S0urceror/HexAgon/3d/stm32f103vet6.stp

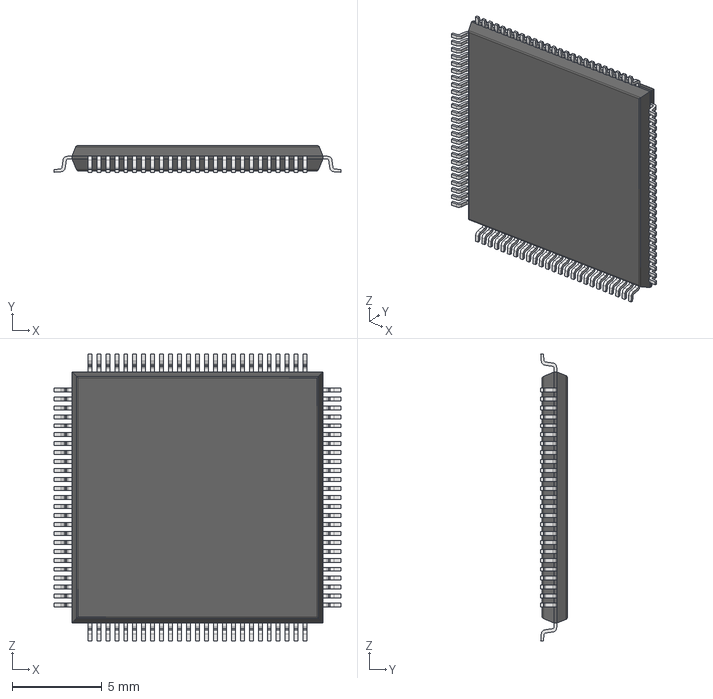
[picture p1: CAD file, 2025-05-18]
3d/stm32f103vet6.stp
16.0 x 1.48 x 16.0 mm
