S0urceror/HexAgon/3d/ESP32-PICO-D4.STEP

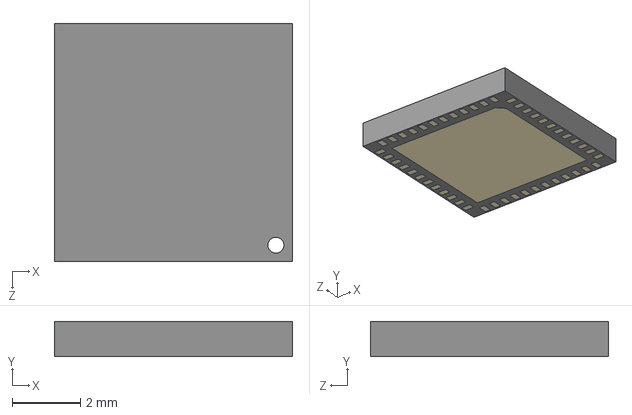
[picture p2: CAD file, 2025-05-18]
3d/ESP32-PICO-D4.STEP
7.00 x 1.04 x 7.00 mm
