S0urceror/HexAgon/3d/HN1x2-PinHeader_1x02_P2.54mm_Vertical.step

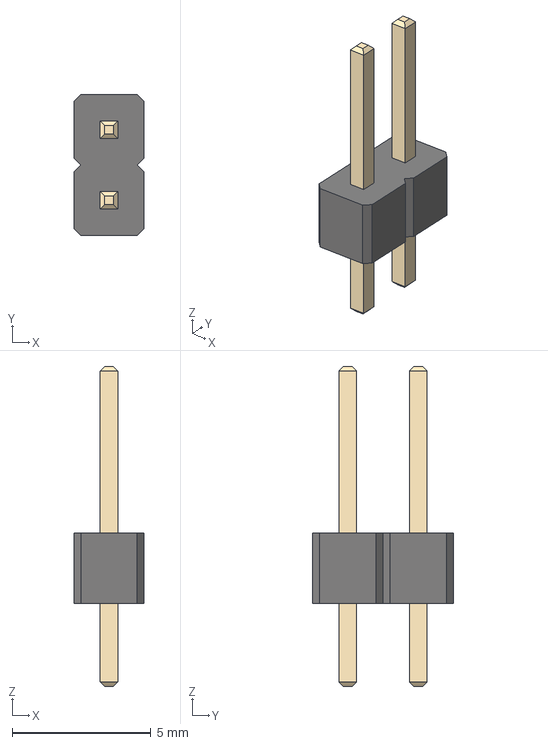
[picture p3: CAD file, 2025-05-18]
3d/HN1x2-PinHeader_1x02_P2.54mm_Vertical.step
2.54 x 5.08 x 11.5 mm
