S0urceror/HexAgon/3d/Audio_Jack-3.5mm---CUI_SJ1-3515-SMT-TR.step

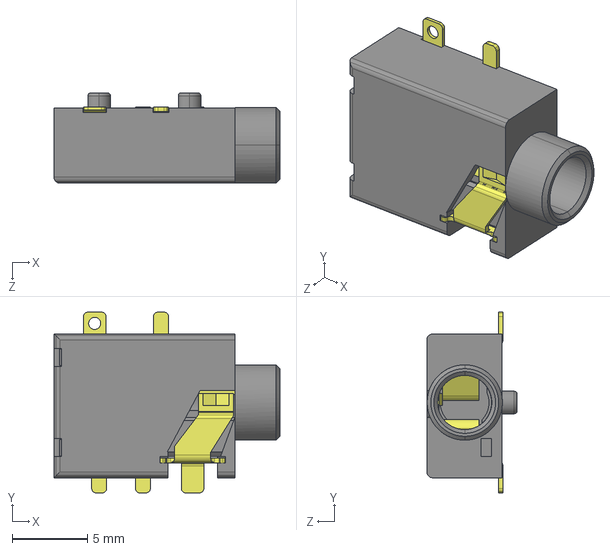
[picture p4: CAD file, 2025-05-18]
3d/Audio_Jack-3.5mm---CUI_SJ1-3515-SMT-TR.step
15.0 x 12.0 x 6.00 mm
