S0urceror/HexAgon/3d/TFC-WPAPR-08---112J-TXAR-R_C_1-1.STEP

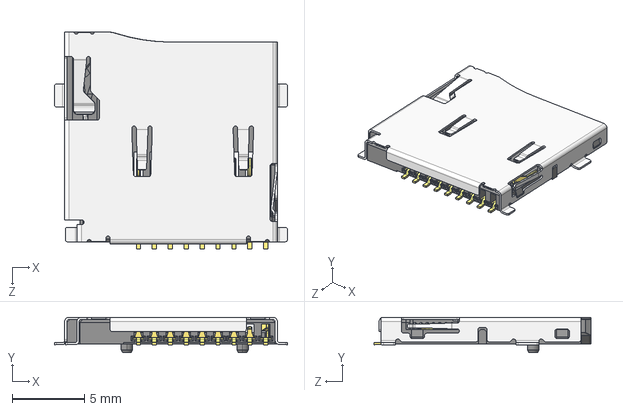
[picture p5: CAD file, 2025-05-18]
3d/TFC-WPAPR-08---112J-TXAR-R_C_1-1.STEP
16.1 x 2.45 x 15.0 mm
