S0urceror/HexAgon/3d/BH-10__64.step

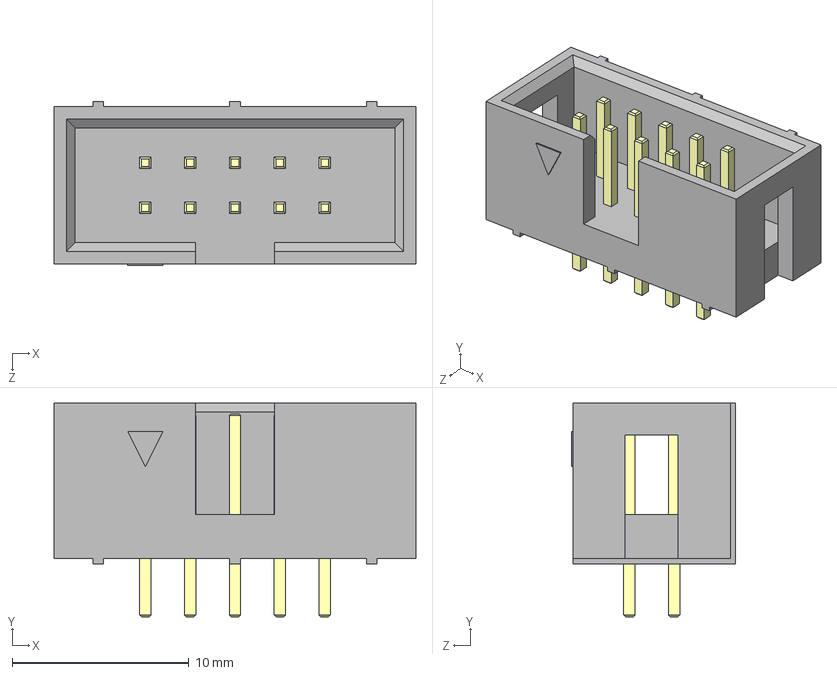
[picture p6: CAD file, 2025-05-18]
3d/BH-10__64.step
20.5 x 12.1 x 9.30 mm
