S0urceror/HexAgon/3d/SOT-23-6.step

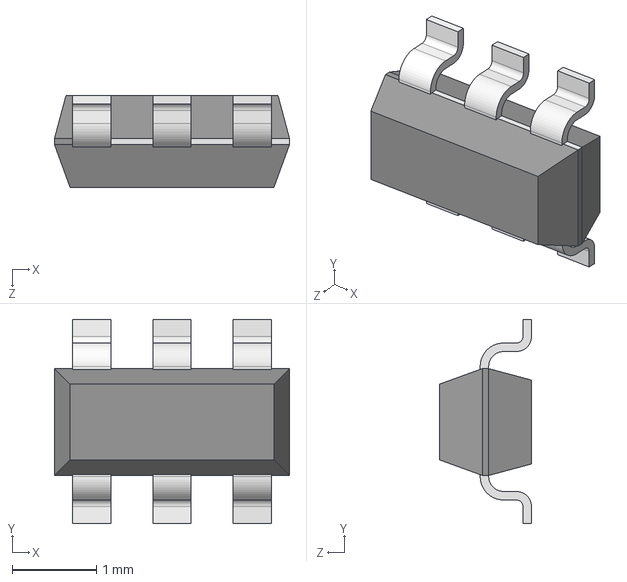
[picture p7: CAD file, 2025-05-18]
3d/SOT-23-6.step
2.79 x 2.43 x 1.09 mm
