S0urceror/HexAgon/3d/Header_right_angle_10way(2x5).step

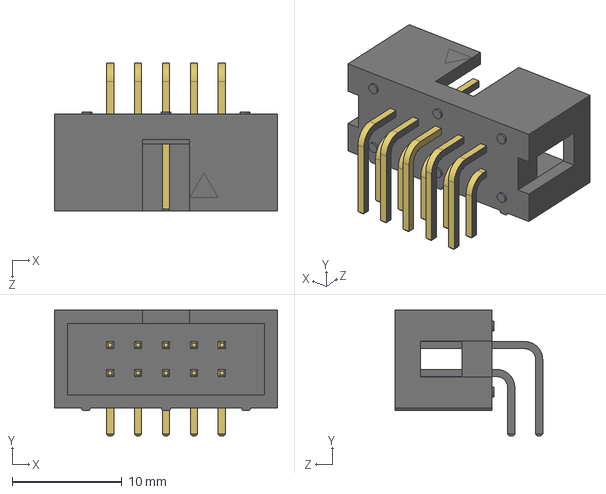
[picture p8: CAD file, 2025-05-18]
3d/Header_right_angle_10way(2x5).step
20.3 x 11.4 x 13.4 mm
