S0urceror/HexAgon/3d/User Library-SLIM D-SUB RIGHT ANGLE PCB MOUNT.step

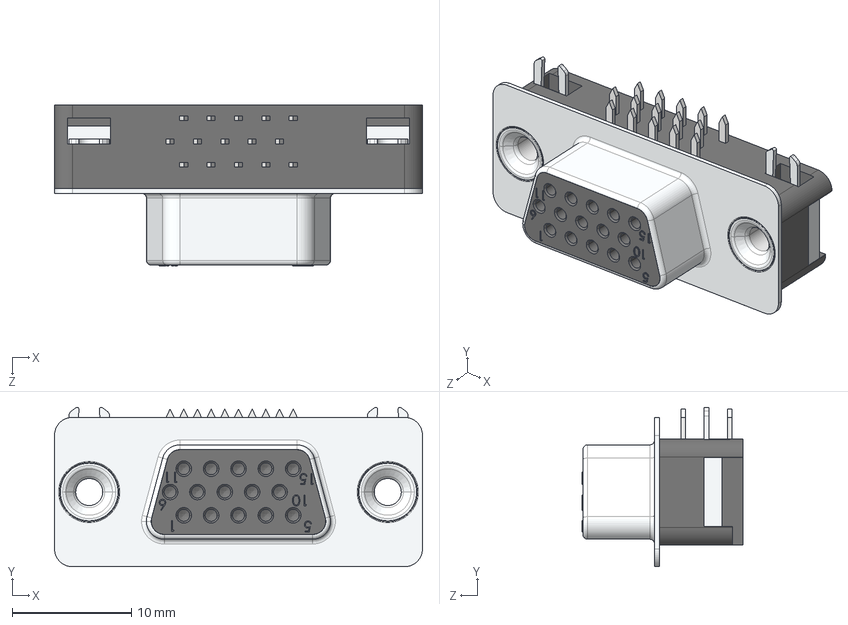
[picture p9: CAD file, 2025-05-18]
3d/User Library-SLIM D-SUB RIGHT ANGLE PCB MOUNT.step
30.8 x 13.3 x 13.5 mm
