S0urceror/HexAgon/3d/ALSRobot-BUZZER.step

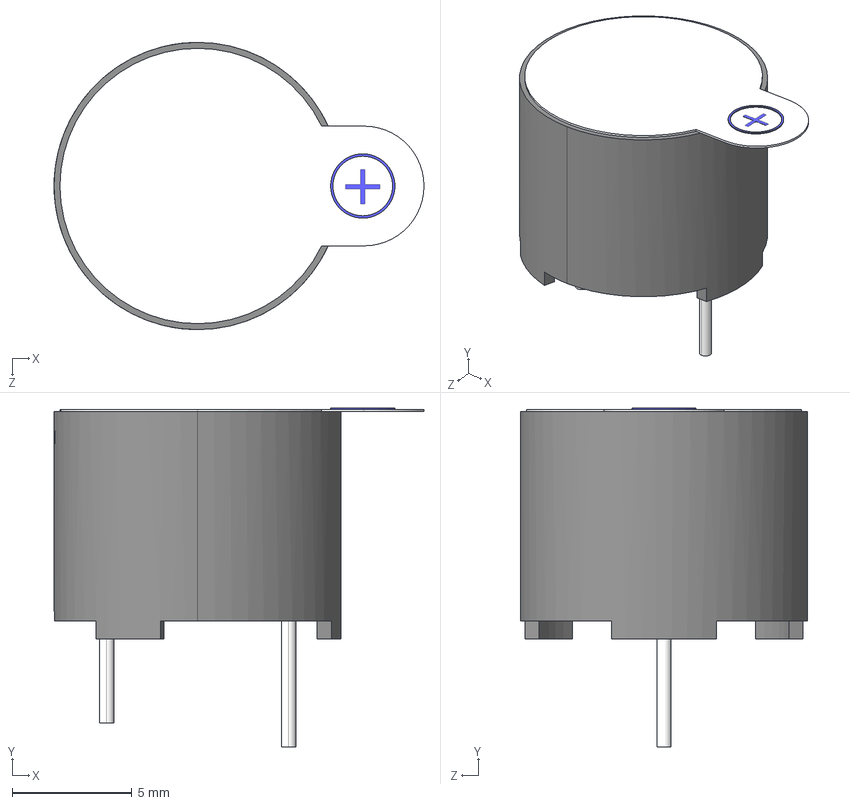
[picture p10: CAD file, 2025-05-18]
3d/ALSRobot-BUZZER.step
15.5 x 14.2 x 12.0 mm
