S0urceror/HexAgon/3d/HN1x4-PinHeader_1x04_P2.54mm_Vertical.step

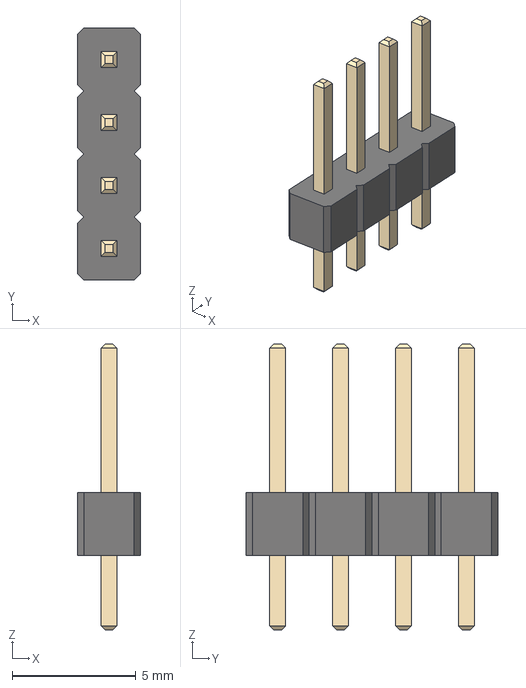
[picture p11: CAD file, 2025-05-18]
3d/HN1x4-PinHeader_1x04_P2.54mm_Vertical.step
2.54 x 10.2 x 11.5 mm
