S0urceror/HexAgon/3d/L-CD32_shielded.step

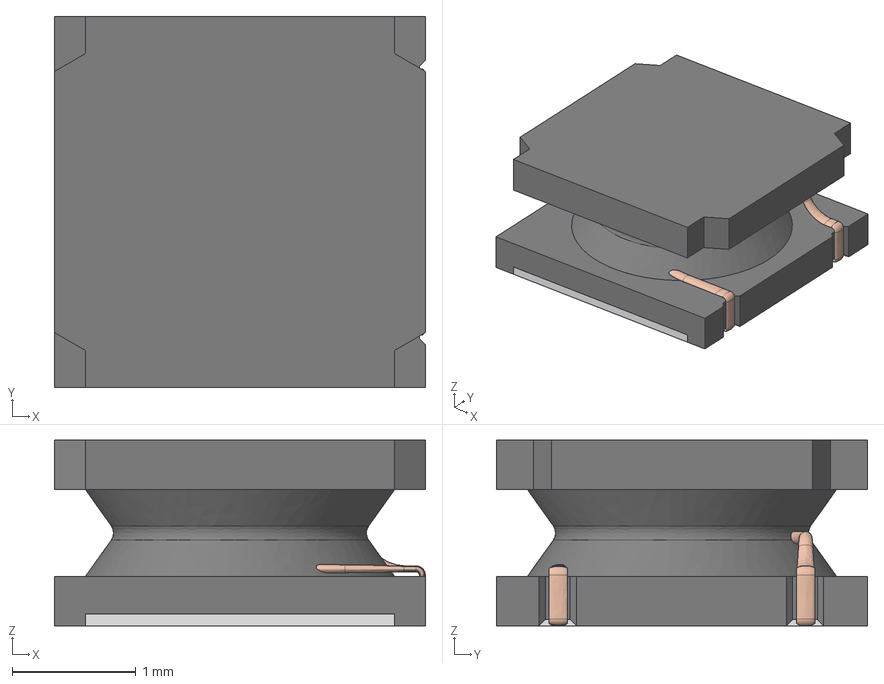
[picture p12: CAD file, 2025-05-18]
3d/L-CD32_shielded.step
3.00 x 3.00 x 1.50 mm
