S0urceror/HexAgon/3d/User Library-SOT50P160X60-6.step

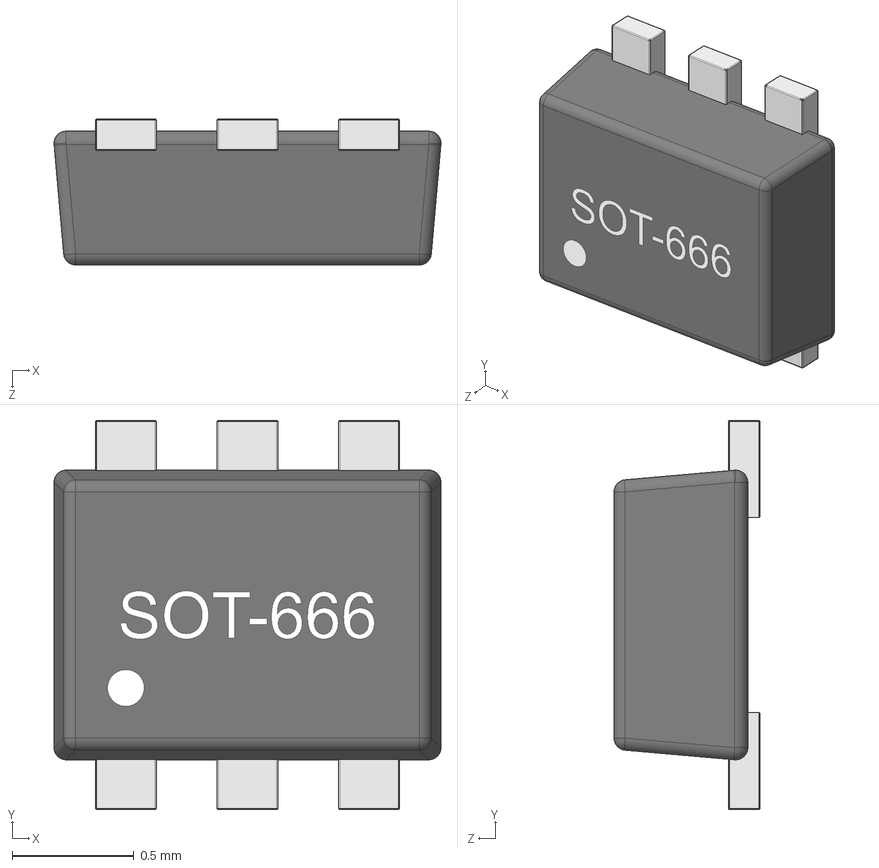
[picture p13: CAD file, 2025-05-18]
3d/User Library-SOT50P160X60-6.step
1.59 x 1.60 x 0.6 mm
