S0urceror/HexAgon/3d/User_Library-TSOP2-44.STEP

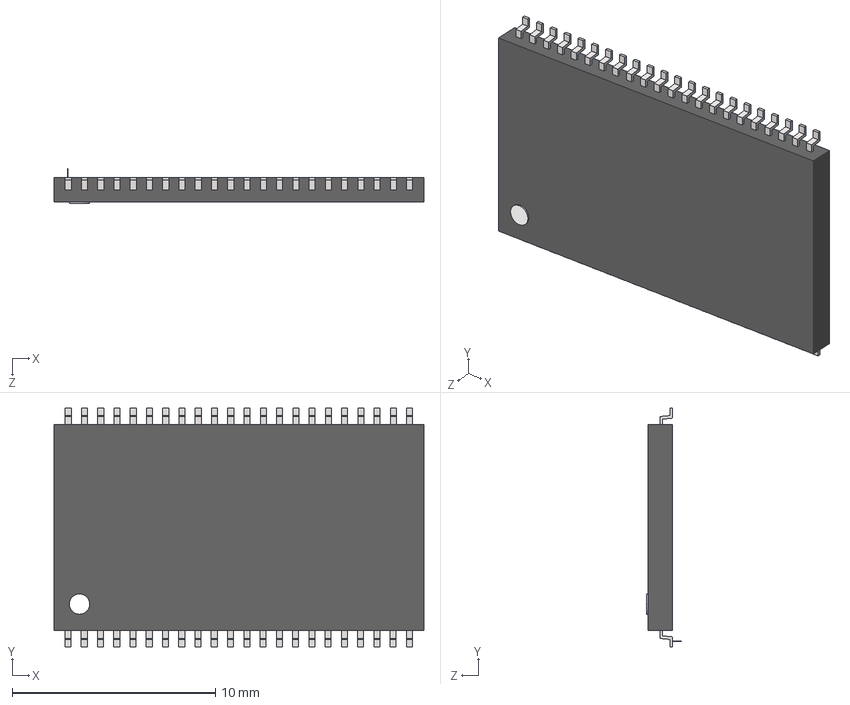
[picture p14: CAD file, 2025-05-18]
3d/User_Library-TSOP2-44.STEP
18.2 x 11.8 x 1.70 mm
Extruded2 x 44
Board4 x 44
Extruded3
Board3
Board5
