S0urceror/HexAgon/3d/SOD123.step

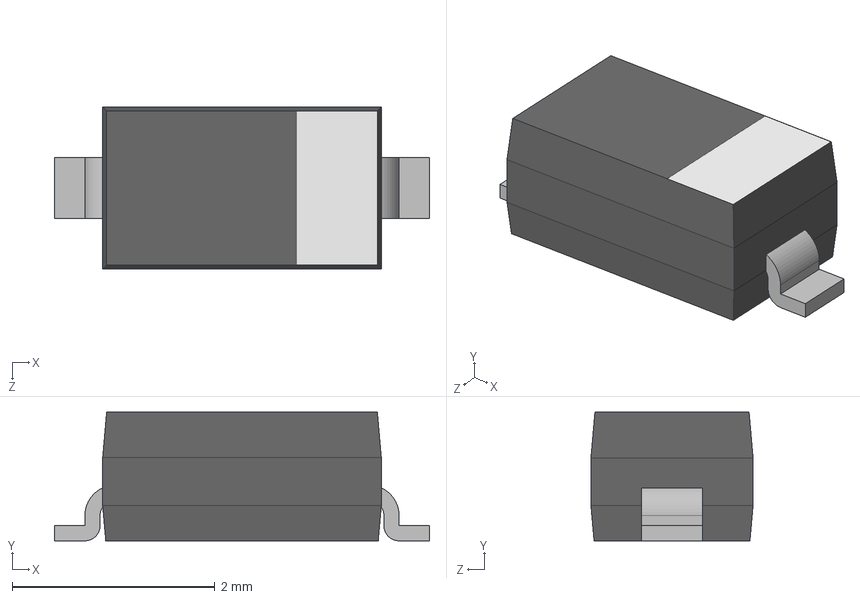
[picture p15: CAD file, 2025-05-18]
3d/SOD123.step
3.70 x 1.27 x 1.60 mm
