S0urceror/HexAgon/3d/SOT-23-5.step

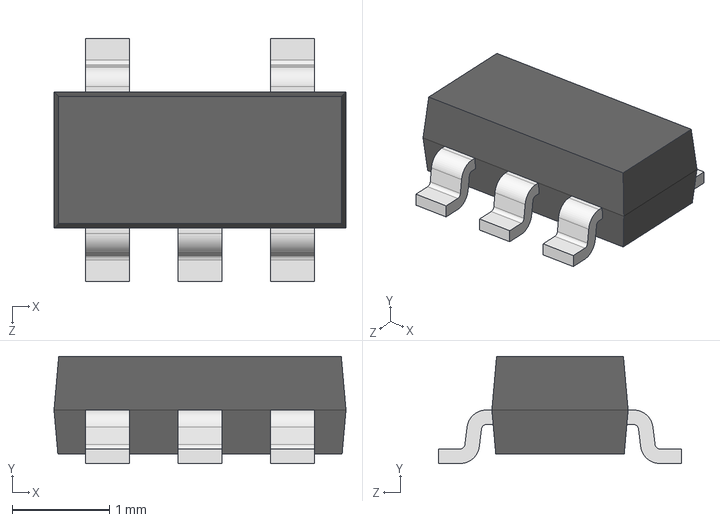
[picture p16: CAD file, 2025-05-18]
3d/SOT-23-5.step
3.00 x 1.10 x 2.50 mm
