S0urceror/HexAgon/3d/QSG5032.step

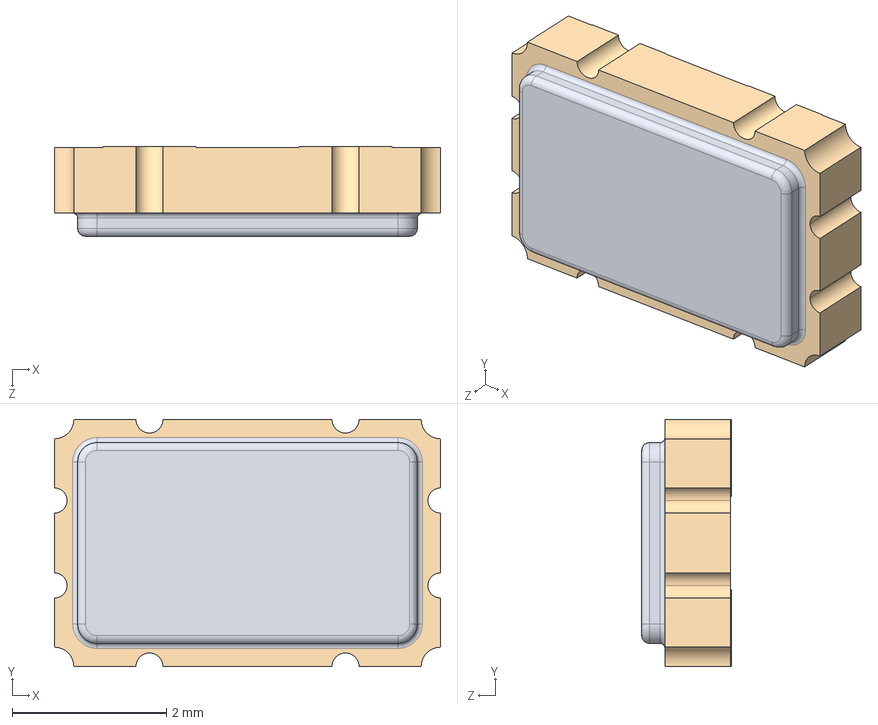
[picture p18: CAD file, 2025-05-18]
3d/QSG5032.step
5.00 x 3.20 x 1.16 mm
