S0urceror/HexAgon/3d/SO-8_150mil---SN65HVDA1050AQDRQ1.STEP

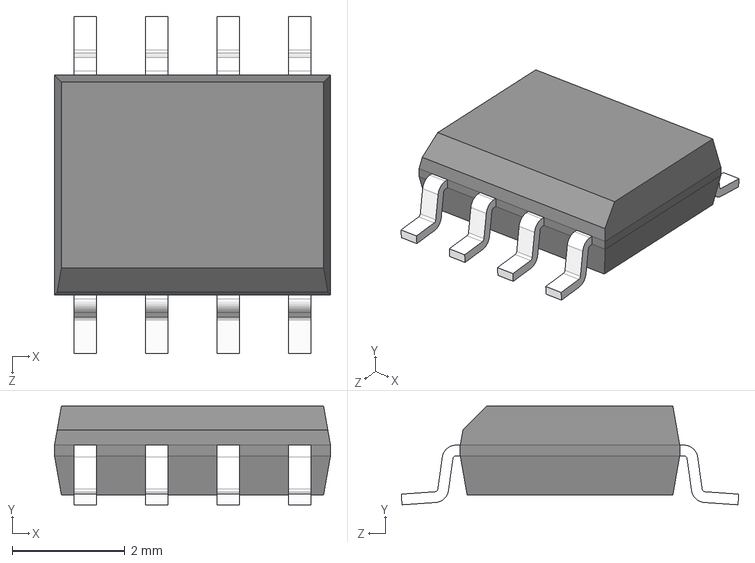
[picture p19: CAD file, 2025-05-18]
3d/SO-8_150mil---SN65HVDA1050AQDRQ1.STEP
4.90 x 1.75 x 5.99 mm
