S0urceror/HexAgon/3d/72w2538_292303-4.stp

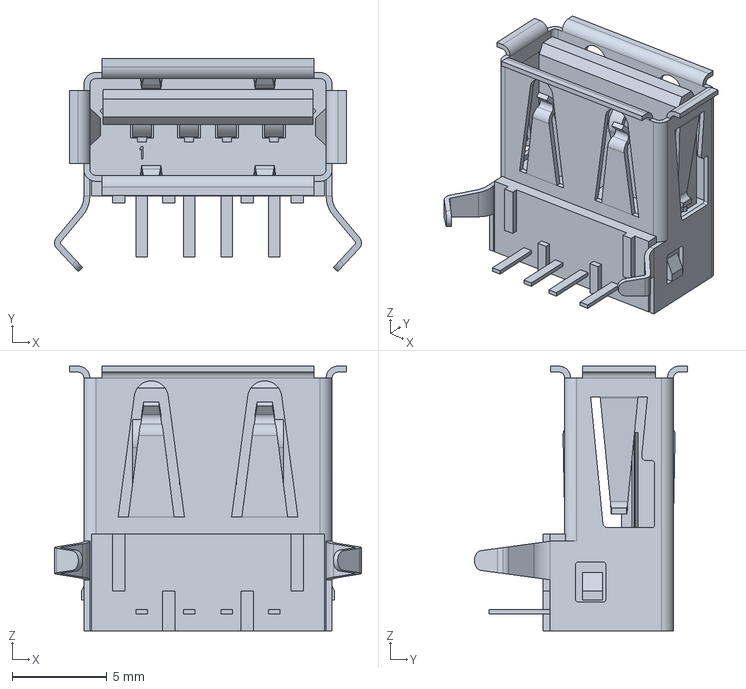
[picture p20: CAD file, 2025-05-18]
3d/72w2538_292303-4.stp
16.2 x 11.3 x 14.0 mm
