S0urceror/HexAgon/3d/JST_B2B-PH-SM4-TB(DW02R).step

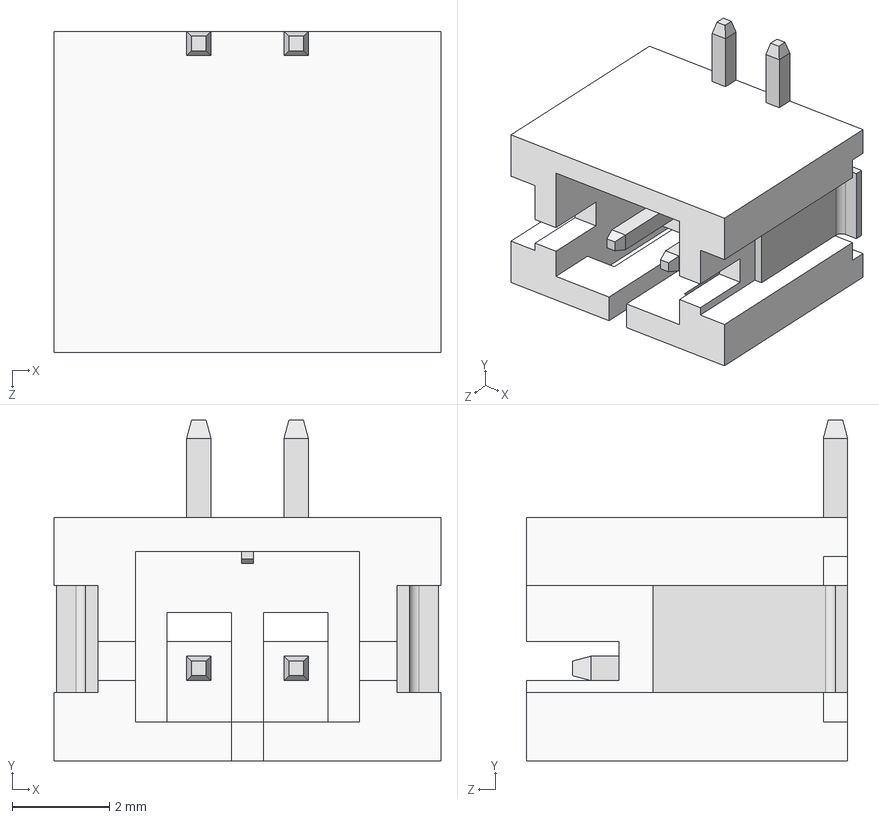
[picture p21: CAD file, 2025-05-18]
3d/JST_B2B-PH-SM4-TB(DW02R).step
7.95 x 7.00 x 6.60 mm
