S0urceror/HexAgon/3d/BH34R_CH87342H100.STEP

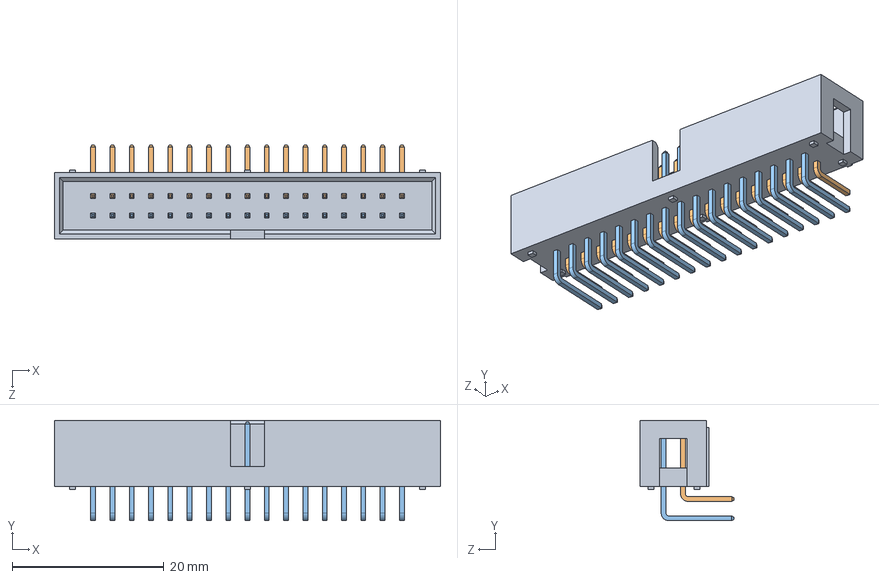
[picture p22: CAD file, 2025-05-18]
3d/BH34R_CH87342H100.STEP
50.8 x 13.2 x 12.4 mm
CH87 BASE_34
H TYPEµuPIN x 17
H TYPEªøPIN x 17
