S0urceror/HexAgon/3d/DO-214AC_SMA.step

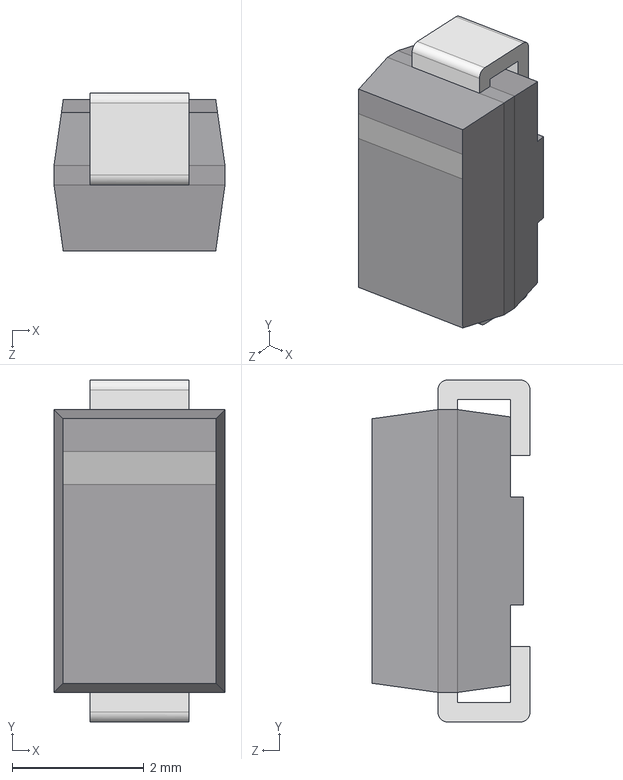
[picture p23: CAD file, 2025-05-18]
3d/DO-214AC_SMA.step
2.60 x 5.20 x 2.40 mm
