S0urceror/HexAgon/3d/B3F_3150.step

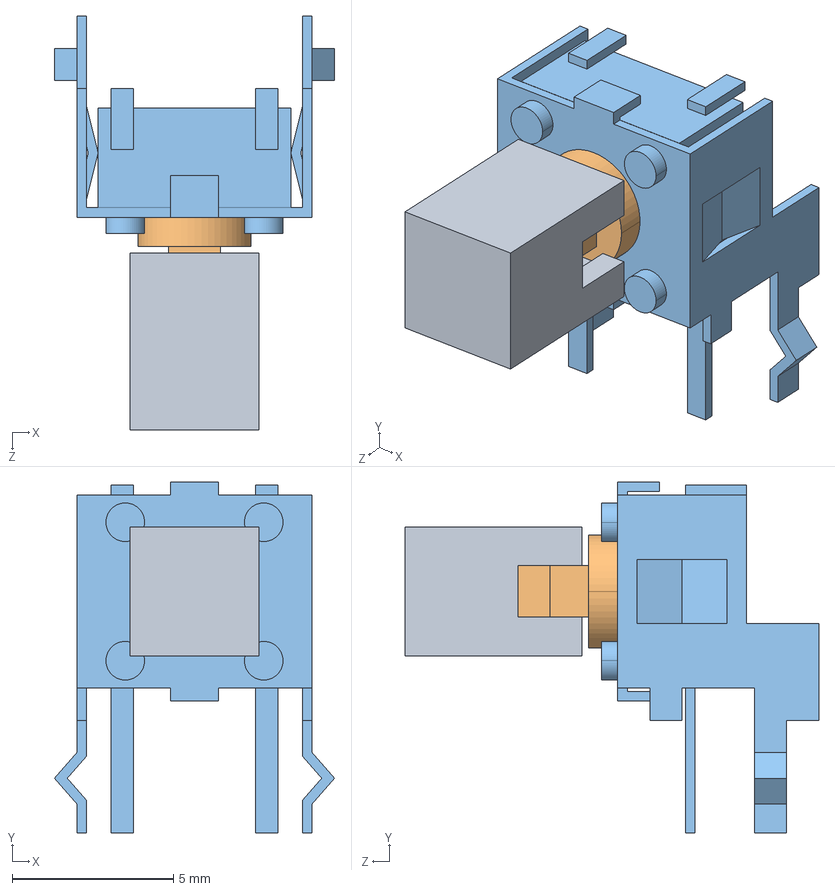
[picture p24: CAD file, 2025-05-18]
3d/B3F_3150.step
8.70 x 10.9 x 12.9 mm
B32_1000
B3F_3150_BUTTON
B3F_3150_BASE
