S0urceror/HexAgon/3d/ESP32-S3-WROOM-1-N8R8.STEP

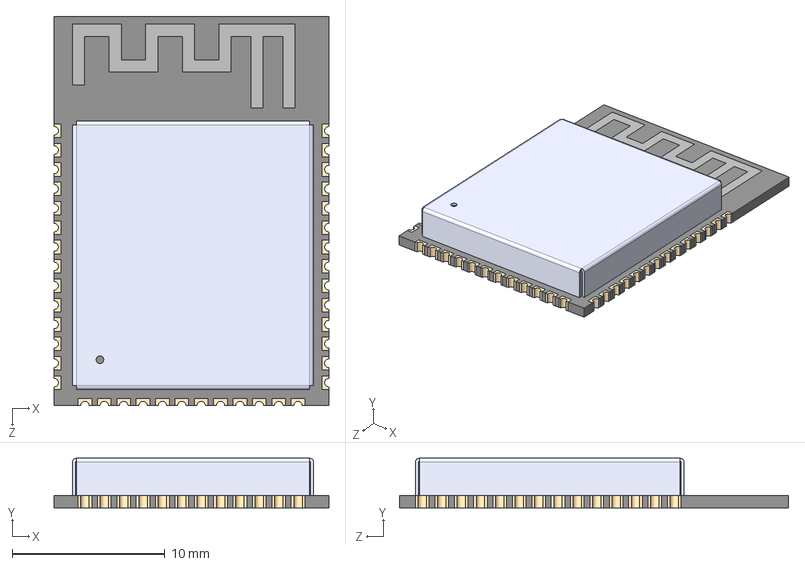
[picture p25: CAD file, 2025-05-18]
3d/ESP32-S3-WROOM-1-N8R8.STEP
18.0 x 3.25 x 25.5 mm
