S0urceror/HexAgon/16bitLCDSS1963/7inch_SSD1963_display_‘≠¿ÌÕº.pdf

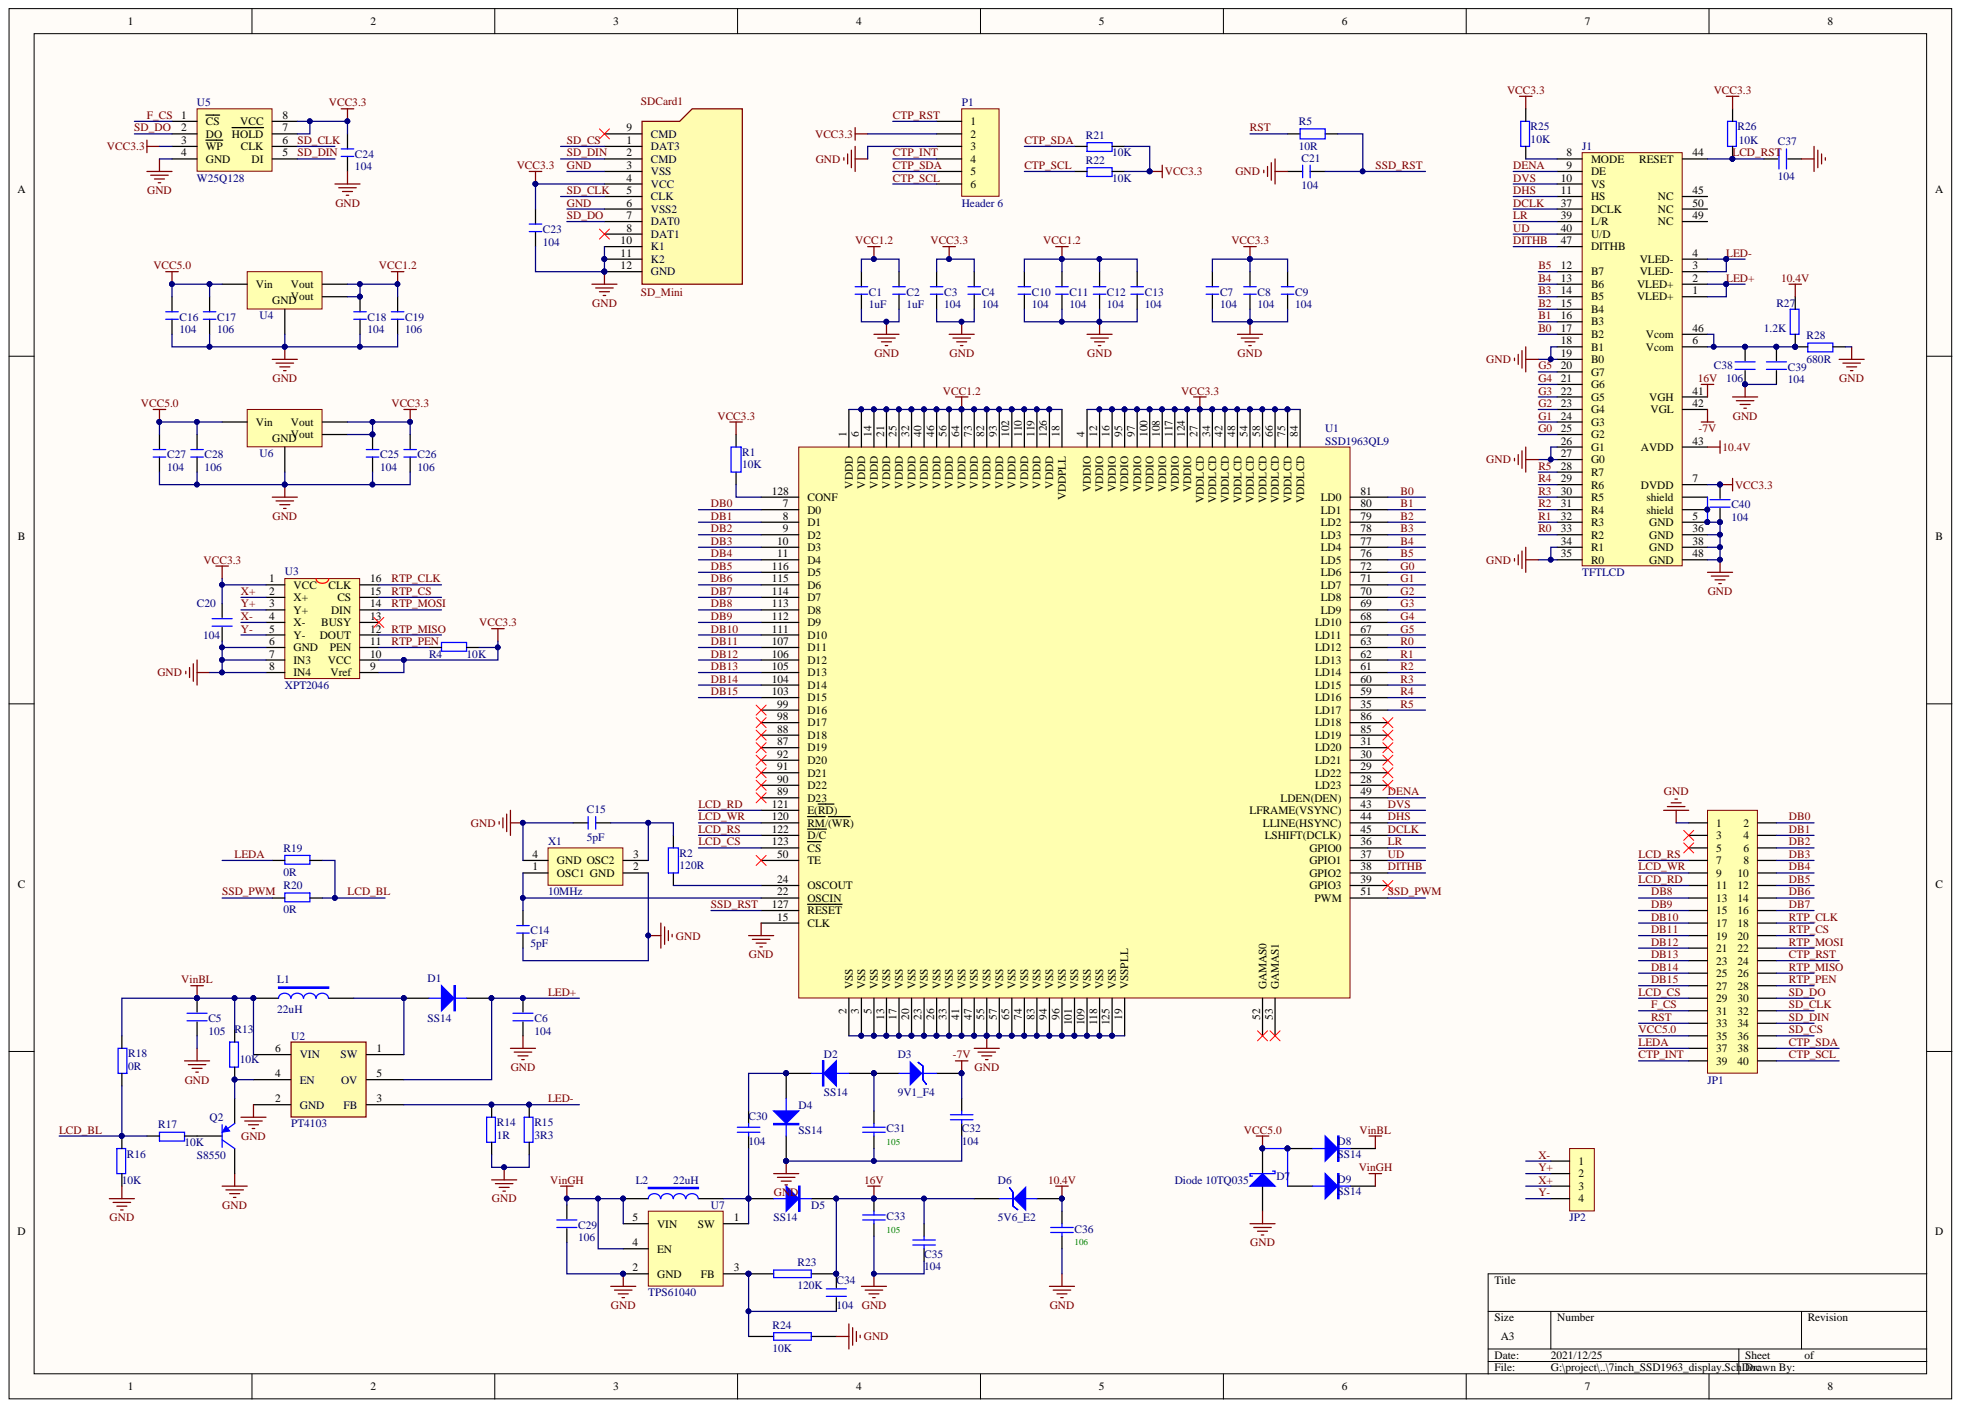
[picture p26: page 1]

GND 2 | LED-
