S0urceror/HexAgon/16bitLCDSS1963/7inch_SSD1963_display_≥ﬂ¥ÁÕº.pdf

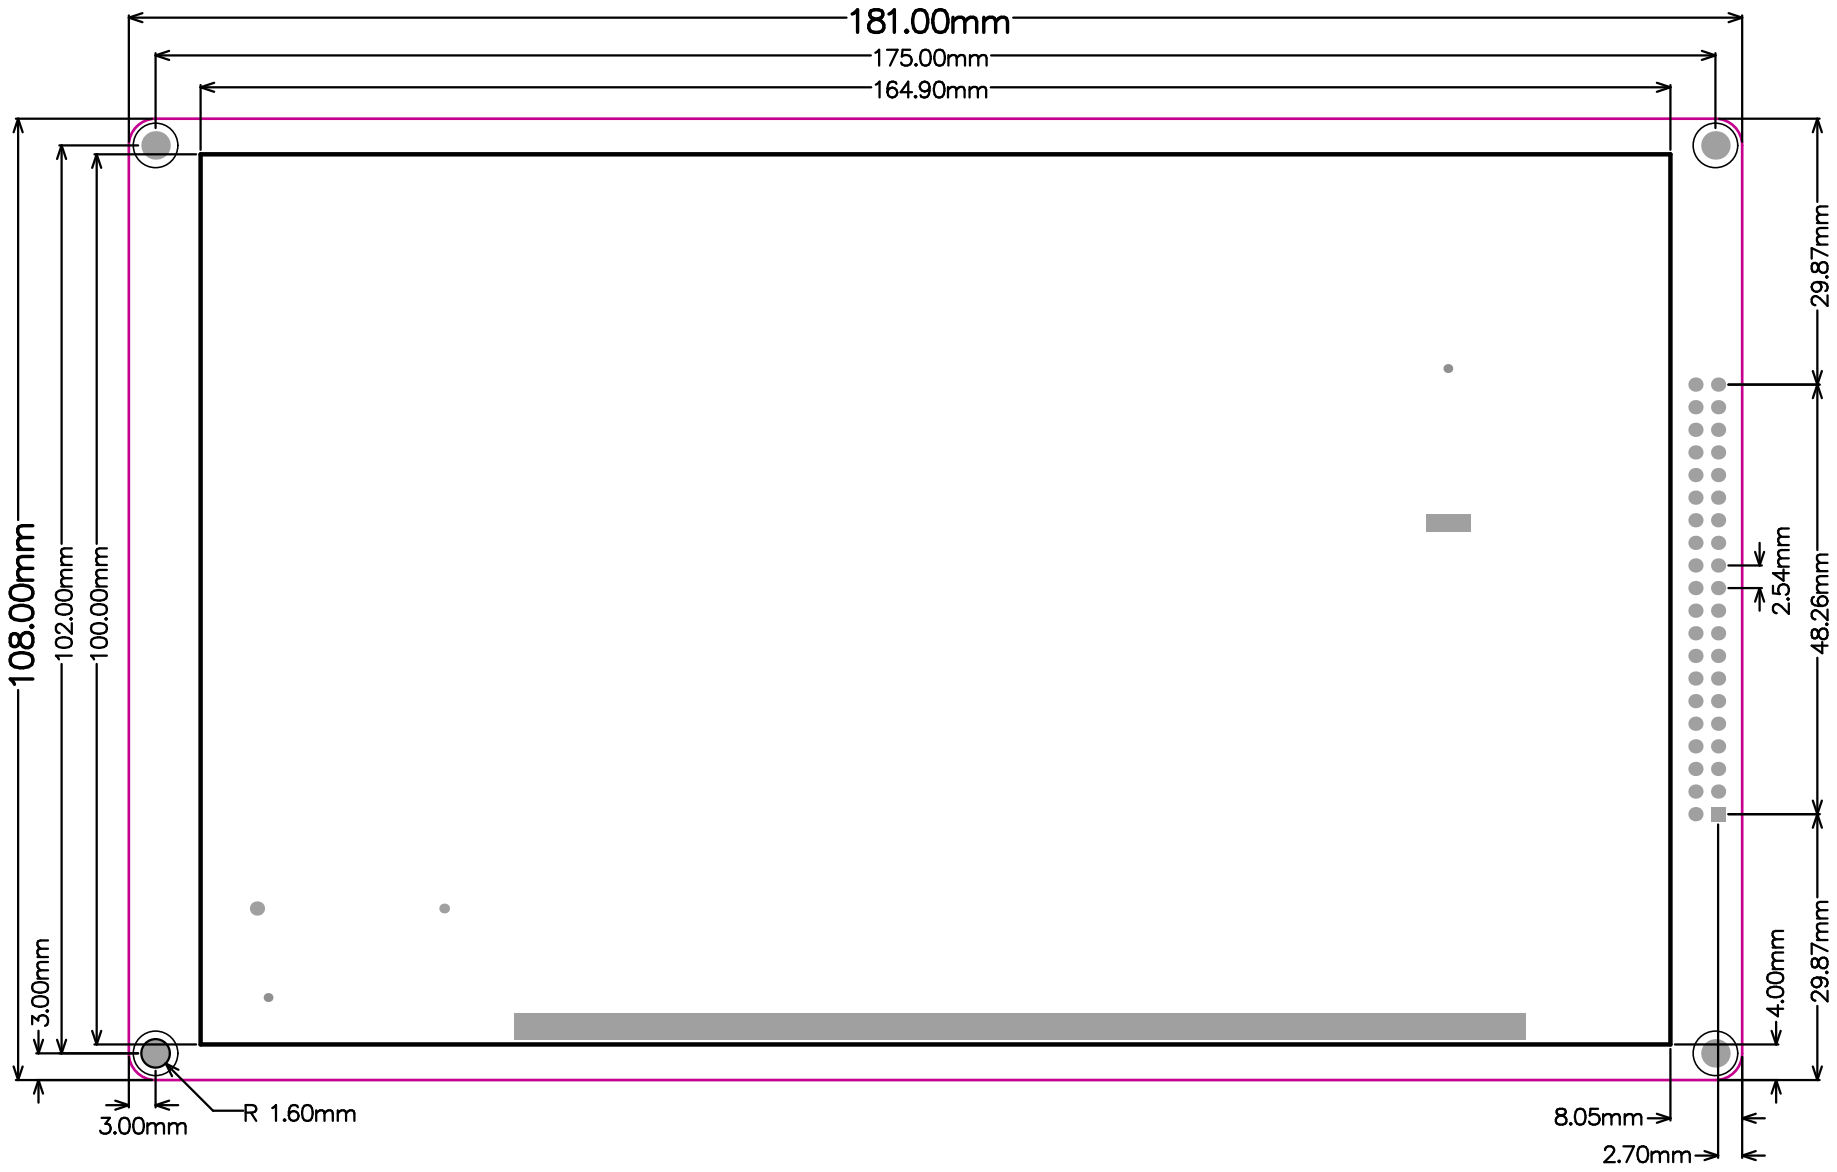
[picture p27: page 1]
