S0urceror/HexAgon/16bitLCDSS1963/TPM7216C.pdf

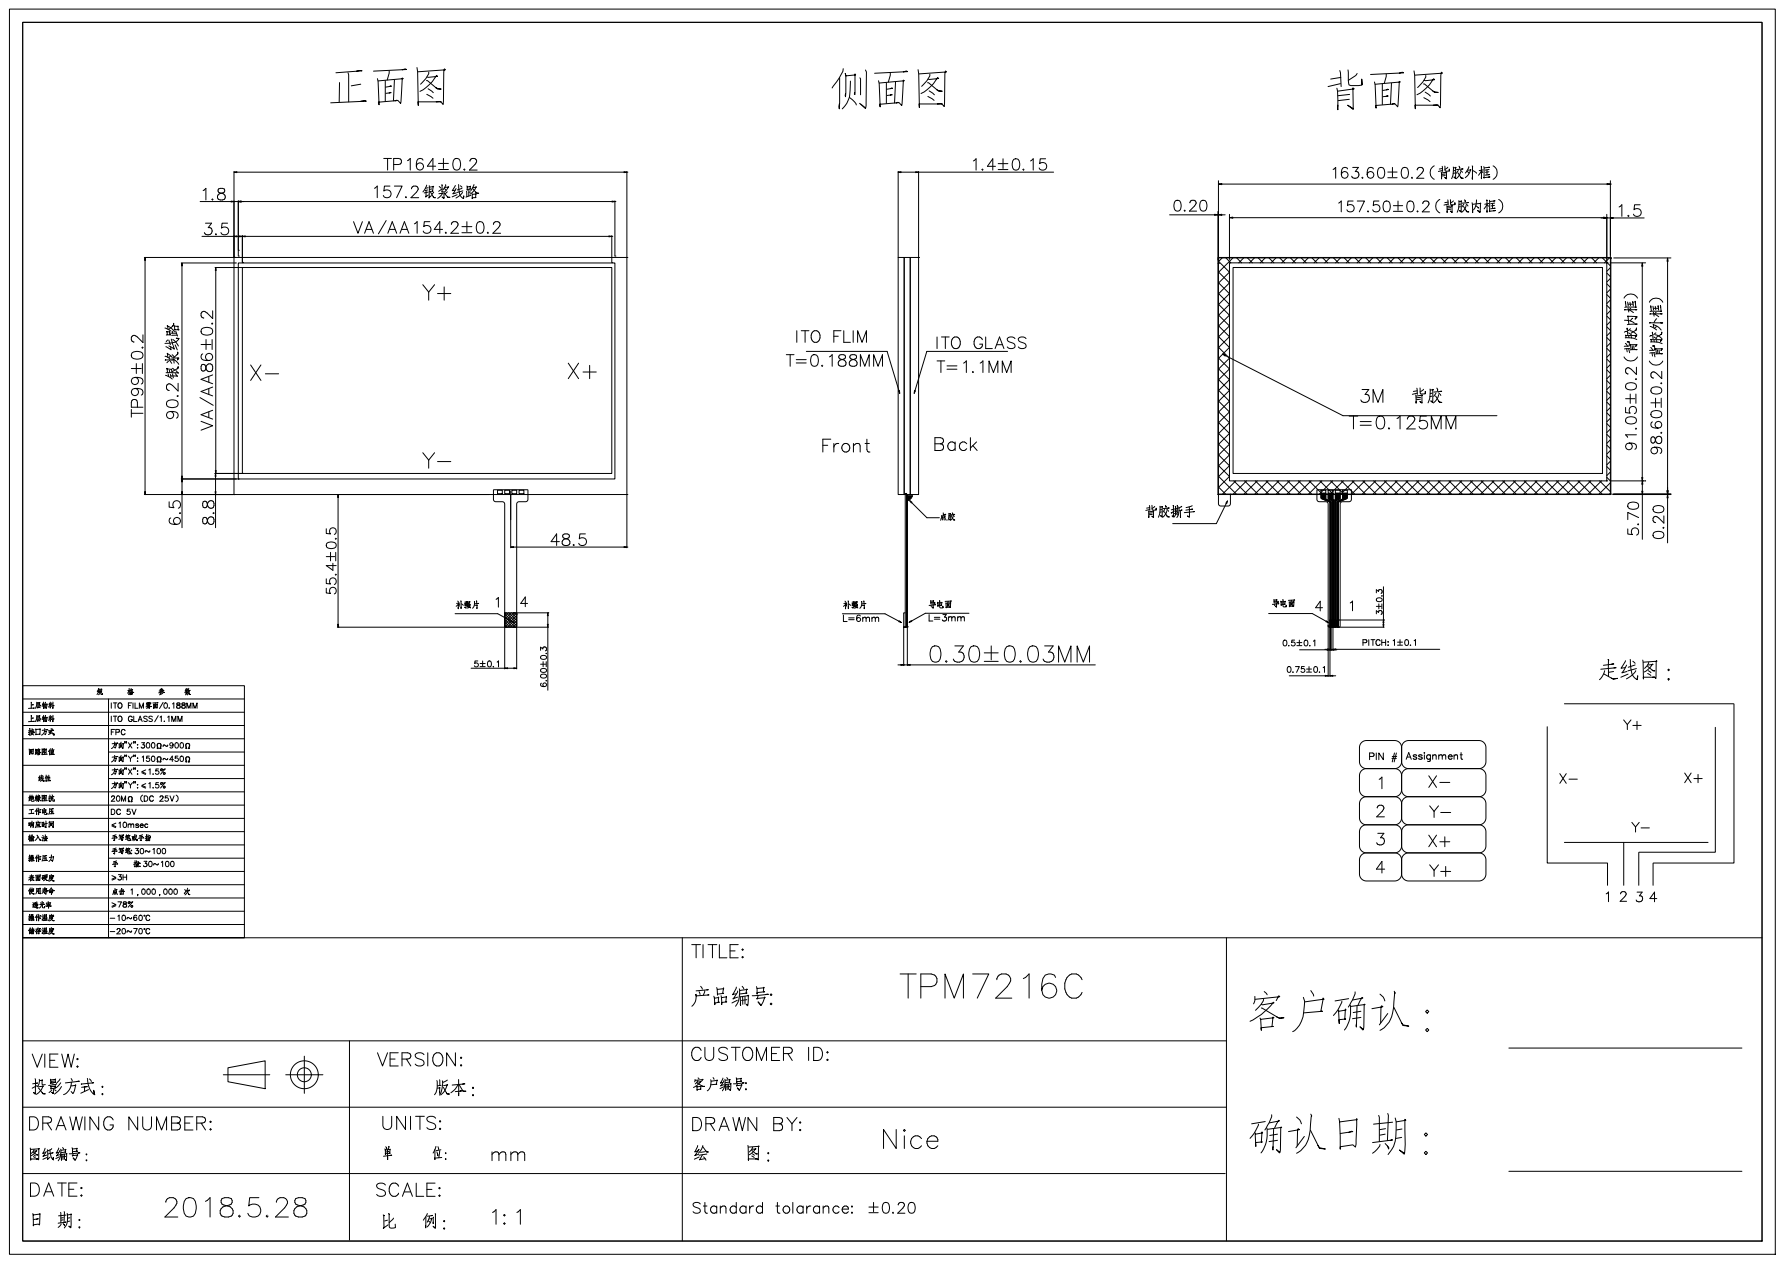
[picture p28: page 1]
