S0urceror/HexAgon/HexAgon.kicad_pcb

## KiCad design HexAgon.kicad_pcb (2025-08-24)

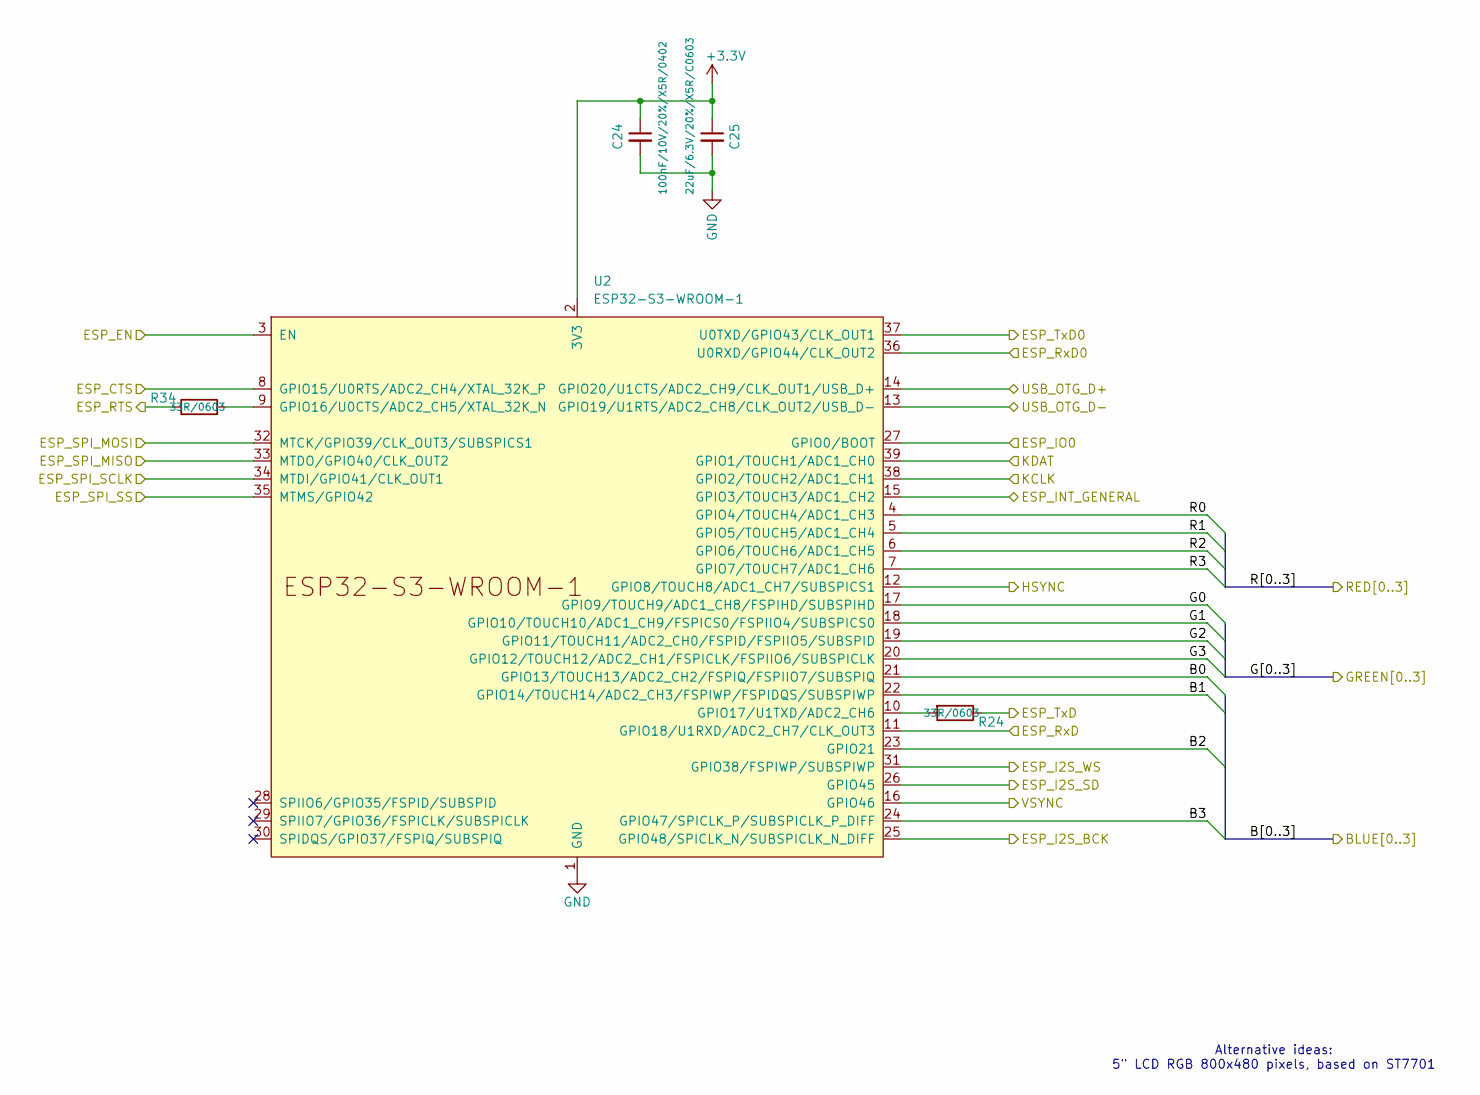
[picture p29: schematic esp32.kicad_sch]

Parts:
C24: 100nF/10V/20%/X5R/0402; C_0402_5MIL_DWS
C25: 22uF/6.3V/20%/X5R/C0603; C_0603_5MIL_DWS
R24, R34: 33R/0603; R_0603_5MIL_DWS
U2: ESP32-S3-WROOM-1

Connections:
+3.3V: C24.1, C25.1, U2.2 (3V3); also elsewhere on the board
/Audio/ESP_I2S_BCK: U2.25 (GPIO48/SPICLK_N/SUBSPICLK_N_DIFF); also elsewhere on the board
/Audio/ESP_I2S_SD: U2.26 (GPIO45); also elsewhere on the board
/Audio/ESP_I2S_WS: U2.31 (GPIO38/FSPIWP/SUBSPIWP); also elsewhere on the board
/ESP32 ports/BOOT_MODE: U2.27 (GPIO0/BOOT); also elsewhere on the board
/ESP32 ports/HOST_RXD: U2.37 (U0TXD/GPIO43/CLK_OUT1); also elsewhere on the board
/ESP32 ports/HOST_TXD: U2.36 (U0RXD/GPIO44/CLK_OUT2); also elsewhere on the board
/ESP32 ports/KCLK: U2.38 (GPIO2/TOUCH2/ADC1_CH1); also elsewhere on the board
/ESP32 ports/KDAT: U2.39 (GPIO1/TOUCH1/ADC1_CH0); also elsewhere on the board
/ESP32 ports/USB_OTG_D+: U2.14 (GPIO20/U1CTS/ADC2_CH9/CLK_OUT1/USB_D+); also elsewhere on the board
/ESP32 ports/USB_OTG_D-: U2.13 (GPIO19/U1RTS/ADC2_CH8/CLK_OUT2/USB_D-); also elsewhere on the board
/ESP32/B0: U2.21 (GPIO13/TOUCH13/ADC2_CH2/FSPIQ/FSPIIO7/S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); also elsewhere on the board
/ESP32/B1: U2.22 (GPIO14/TOUCH14/ADC2_CH3/FSPIWP/FSPIDQS/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); also elsewhere on the board
/ESP32/B2: U2.23 (GPIO21); also elsewhere on the board
/ESP32/B3: U2.24 (GPIO47/SPICLK_P/SUBSPICLK_P_DIFF); also elsewhere on the board
/ESP32/ESP_CTS: U2.8 (GPIO15/U0RTS/ADC2_CH4/XTAL_32K_P); also elsewhere on the board
/ESP32/ESP_INT_GENERAL: U2.15 (GPIO3/TOUCH3/ADC1_CH2); also elsewhere on the board
/ESP32/ESP_RTS: R34.1; also elsewhere on the board
/ESP32/ESP_RxD: U2.11 (GPIO18/U1RXD/ADC2_CH7/CLK_OUT3); also elsewhere on the board
/ESP32/ESP_SPI_MISO: U2.33 (MTDO/GPIO40/CLK_OUT2); also elsewhere on the board
/ESP32/ESP_SPI_MOSI: U2.32 (MTCK/GPIO39/CLK_OUT3/SUBSPICS1); also elsewhere on the board
/ESP32/ESP_SPI_SCLK: U2.34 (MTDI/GPIO41/CLK_OUT1); also elsewhere on the board
/ESP32/ESP_SPI_SS: U2.35 (MTMS/GPIO42); also elsewhere on the board
/ESP32/ESP_TxD: R24.1; also elsewhere on the board
/ESP32/G0: U2.17 (GPIO9/TOUCH9/ADC1_CH8/FSPIHD/SUBSPIHD); also elsewhere on the board
/ESP32/G1: U2.18 (GPIO10/TOUCH10/ADC1_CH9/FSPICS0/FSPIIO4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); also elsewhere on the board
/ESP32/G2: U2.19 (GPIO11/TOUCH11/ADC2_CH0/FSPID/FSPIIO5/S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); also elsewhere on the board
/ESP32/G3: U2.20 (GPIO12/TOUCH12/ADC2_CH1/FSPICLK/FSPIIO6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); also elsewhere on the board
/ESP32/HSYNC: U2.12 (GPIO8/TOUCH8/ADC1_CH7/SUBSPICS1); also elsewhere on the board
/ESP32/R0: U2.4 (GPIO4/TOUCH4/ADC1_CH3); also elsewhere on the board
/ESP32/R1: U2.5 (GPIO5/TOUCH5/ADC1_CH4); also elsewhere on the board
/ESP32/R2: U2.6 (GPIO6/TOUCH6/ADC1_CH5); also elsewhere on the board
/ESP32/R3: U2.7 (GPIO7/TOUCH7/ADC1_CH6); also elsewhere on the board
/ESP32/VSYNC: U2.16 (GPIO46); also elsewhere on the board
/EZ80/~RESET: U2.3 (EN); also elsewhere on the board
GND: C24.2, C25.2, U2.1 (GND), U2.40 (GND), U2.41 (GND); also elsewhere on the board
unnamed: R34.2, U2.9 (GPIO16/U0CTS/ADC2_CH5/XTAL_32K_N)
unnamed: R24.2, U2.10 (GPIO17/U1TXD/ADC2_CH6)

Notes on the sheet:
Alternative ideas: 5" LCD RGB 800x480 pixels, based on ST7701

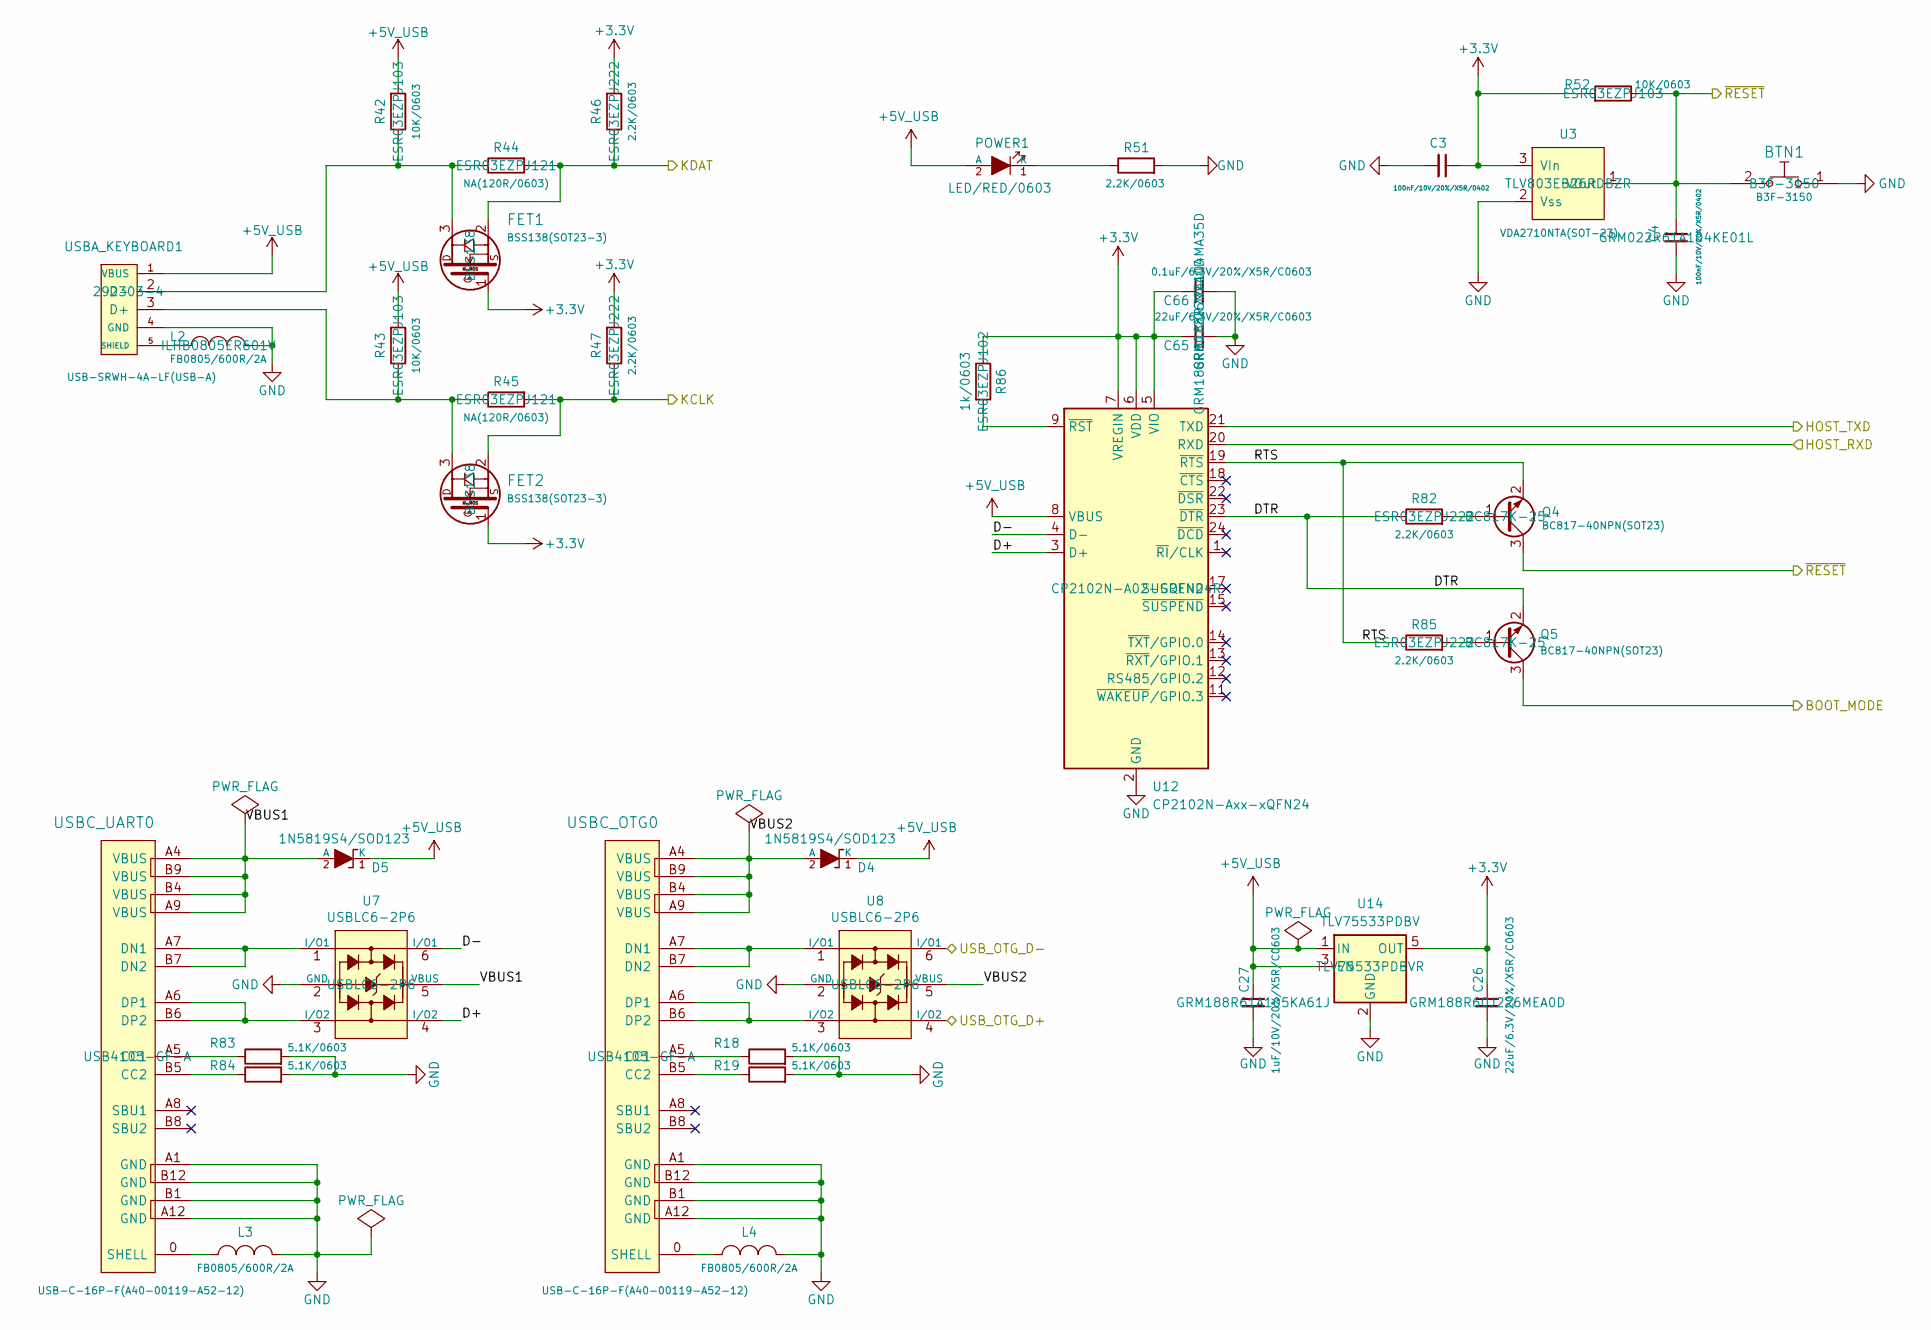
[picture p30: schematic keyboard_usb.kicad_sch]

Parts:
BTN1: B3F-3150; B3F-31XX
C3, C4: 100nF/10V/20%/X5R/0402; C_0402_5MIL_DWS
C26, C65: 22uF/6.3V/20%/X5R/C0603; C_0603_5MIL_DWS
C27: 1uF/10V/20%/X5R/C0603; C_0603_5MIL_DWS
C66: 0.1uF/6.3V/20%/X5R/C0603; C_0603_5MIL_DWS
D4, D5: 1N5819S4/SOD123; SOD-123_1C-2A_KA
FET1, FET2: BSS138(SOT23-3); SOT23
L2, L3, L4: FB0805/600R/2A; L_0805_5MIL_DWS
POWER1: LED/RED/0603; LED_0603_KA
Q4, Q5: BC817-40NPN(SOT23); SOT23
R18, R19, R83, R84: 5.1K/0603; R_0603_5MIL_DWS
R42, R43, R52: 10K/0603; R_0603_5MIL_DWS
R44, R45: NA(120R/0603); R_0603_5MIL_DWS
R46, R47, R51, R82, R85: 2.2K/0603; R_0603_5MIL_DWS
R86: 1k/0603; R_0603_5MIL_DWS
U3: VDA2710NTA(SOT-23); SOT-23
U7, U8: USBLC6-2P6; SOT-666
U12: CP2102N-Axx-xQFN24; QFN-24-1EP_4x4mm_P0.5mm_EP2.6x2.6mm
U14: TLV75533PDBV; SOT-23-5
USBA_KEYBOARD1: USB-SRWH-4A-LF(USB-A); USB_PN87520_HOST_PTH
USBC_OTG0: USB-C-16P-F(A40-00119-A52-12); USB2.0_TYPE-C(A40-00119-A52-12)
USBC_UART0: USB-C-16P-F(A40-00119-A52-12); USB2.0_TYPE-C(A40-00119-A52-12)

Connections:
+3.3V: C3.1, C26.1, C65.1, C66.1, FET1.1 (G), FET2.1 (G), R46.2, R47.2, R52.2, R86.1, U3.3 (VIn), U12.5 (VIO), U12.6 (VDD), U12.7 (VREGIN), U14.5 (OUT); also elsewhere on the board
+5V_USB: C27.1, D4.1 (K), D5.1 (K), POWER1.2 (A), R42.2, R43.2, U12.8 (VBUS), U14.1 (IN), U14.3 (EN), USBA_KEYBOARD1.1 (VBUS); also elsewhere on the board
/ESP32 ports/BOOT_MODE: Q5.3 (C); also elsewhere on the board
/ESP32 ports/D+: U7.4 (I/O2), U12.3 (D+)
/ESP32 ports/D-: U7.6 (I/O1), U12.4 (D-)
/ESP32 ports/DTR: Q5.2 (E), R82.1, U12.23 (~DTR)
/ESP32 ports/HOST_RXD: U12.20 (RXD); also elsewhere on the board
/ESP32 ports/HOST_TXD: U12.21 (TXD); also elsewhere on the board
/ESP32 ports/KCLK: FET2.2 (S), R45.2, R47.1; also elsewhere on the board
/ESP32 ports/KDAT: FET1.2 (S), R44.2, R46.1; also elsewhere on the board
/ESP32 ports/RTS: Q4.2 (E), R85.1, U12.19 (~RTS)
/ESP32 ports/USB_OTG_D+: U8.4 (I/O2); also elsewhere on the board
/ESP32 ports/USB_OTG_D-: U8.6 (I/O1); also elsewhere on the board
/ESP32 ports/VBUS1: D5.2 (A), U7.5 (VBUS), USBC_UART0.A4 (VBUS), USBC_UART0.A9 (VBUS), USBC_UART0.B4 (VBUS), USBC_UART0.B9 (VBUS)
/ESP32 ports/VBUS2: D4.2 (A), U8.5 (VBUS), USBC_OTG0.A4 (VBUS), USBC_OTG0.A9 (VBUS), USBC_OTG0.B4 (VBUS), USBC_OTG0.B9 (VBUS)
/EZ80/~RESET: BTN1.2, C4.2, Q4.3 (C), R52.1, U3.1 (VOut); also elsewhere on the board
GND: BTN1.1, C3.2, C4.1, C26.2, C27.2, C65.2, C66.2, L2.2, L3.2, L4.2, R18.2, R19.2, R51.2, R83.2, R84.2, U3.2 (Vss), U7.2 (GND), U8.2 (GND), U12.2 (GND), U12.25 (GND), U14.2 (GND), USBA_KEYBOARD1.4 (GND), USBC_OTG0.A1 (GND), USBC_OTG0.A12 (GND), USBC_OTG0.B1 (GND), USBC_OTG0.B12 (GND), USBC_UART0.A1 (GND), USBC_UART0.A12 (GND), USBC_UART0.B1 (GND), USBC_UART0.B12 (GND); also elsewhere on the board
unnamed: FET1.3 (D), R42.1, R44.1, USBA_KEYBOARD1.2 (D-)
unnamed: FET2.3 (D), R43.1, R45.1, USBA_KEYBOARD1.3 (D+)
unnamed: POWER1.1 (K), R51.1
unnamed: Q4.1 (B), R82.2
unnamed: Q5.1 (B), R85.2
unnamed: R86.2, U12.9 (~RST)
unnamed: L2.1, USBA_KEYBOARD1.5 (SHIELD)
unnamed: R18.1, USBC_OTG0.A5 (CC1)
unnamed: R19.1, USBC_OTG0.B5 (CC2)
unnamed: U8.1 (I/O1), USBC_OTG0.A7 (DN1), USBC_OTG0.B7 (DN2)
unnamed: U8.3 (I/O2), USBC_OTG0.A6 (DP1), USBC_OTG0.B6 (DP2)
unnamed: L4.1, USBC_OTG0.0 (SHELL)
unnamed: R83.1, USBC_UART0.A5 (CC1)
unnamed: R84.1, USBC_UART0.B5 (CC2)
unnamed: U7.1 (I/O1), USBC_UART0.A7 (DN1), USBC_UART0.B7 (DN2)
unnamed: U7.3 (I/O2), USBC_UART0.A6 (DP1), USBC_UART0.B6 (DP2)
unnamed: L3.1, USBC_UART0.0 (SHELL)

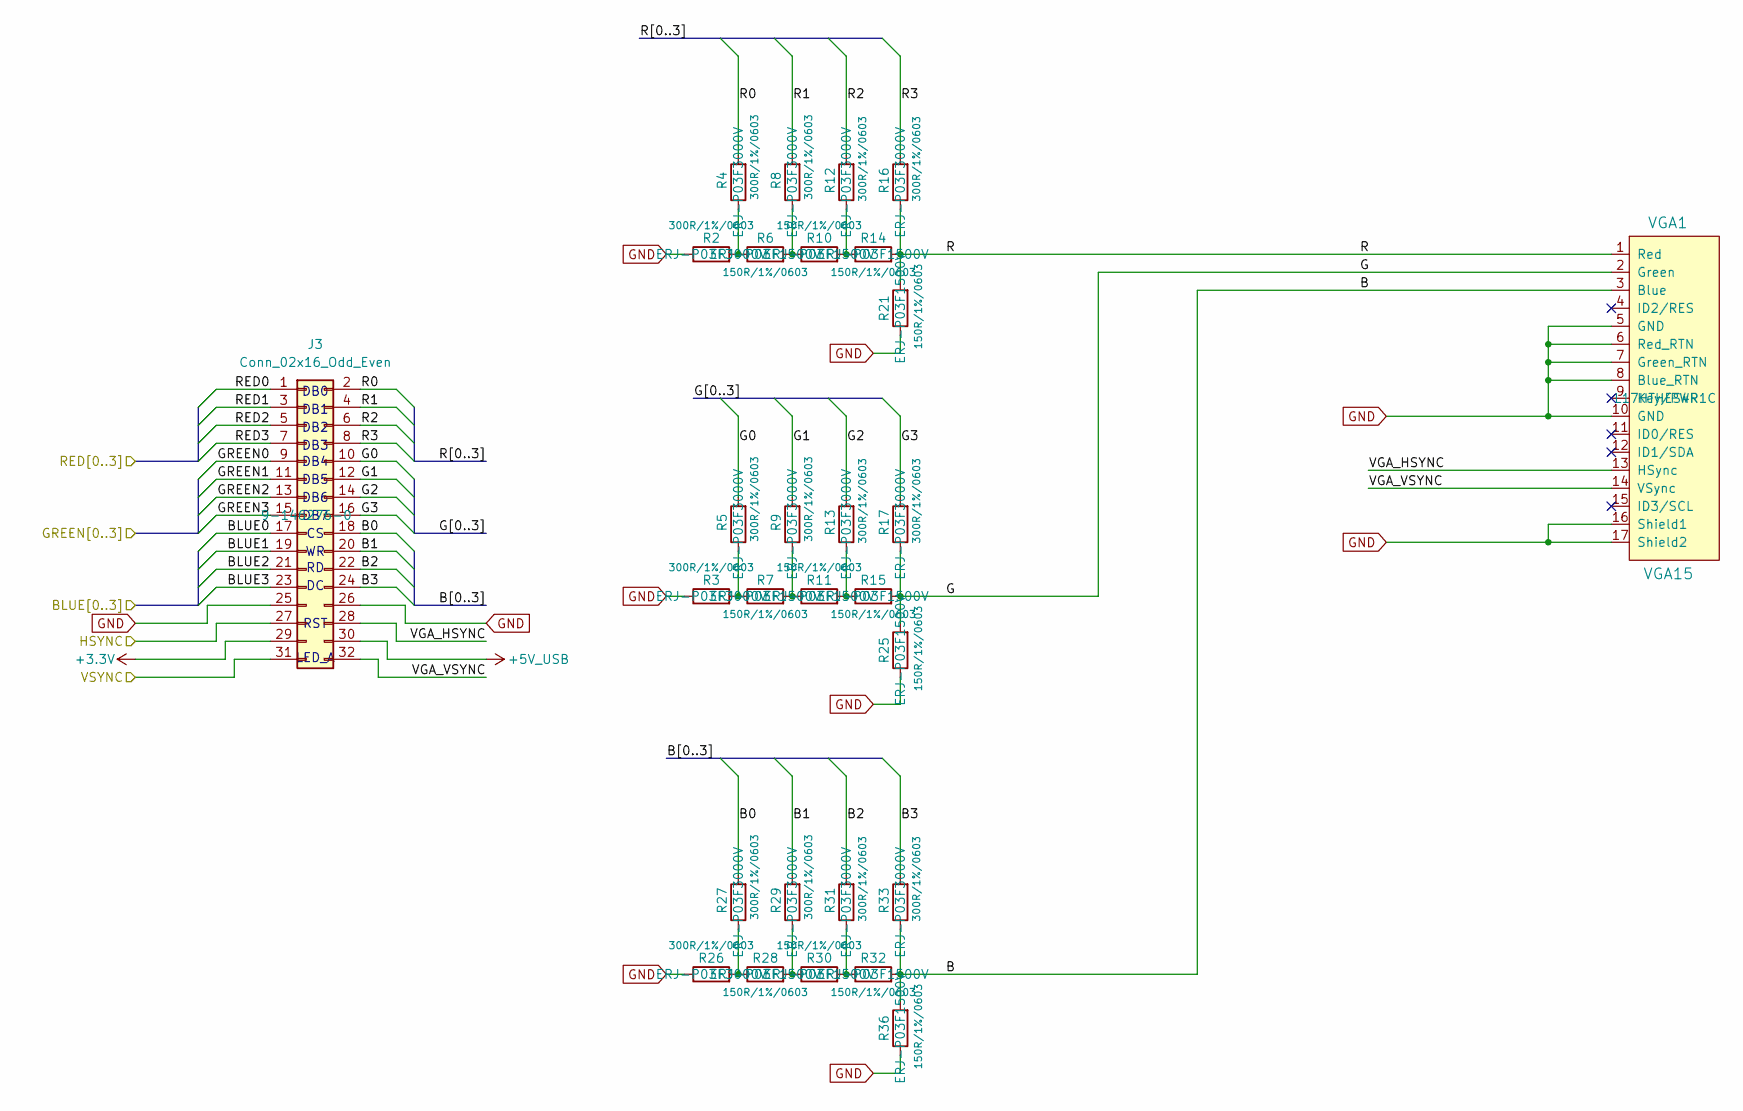
[picture p31: schematic video.kicad_sch]

Parts:
J3: Conn_02x16_Odd_Even; PinHeader_2x16_P2.54mm_Vertical_SMD
R2, R3, R4, R5, R8, R9, R12, R13, R16, R17, R26, R27, R29, R31, R33: 300R/1%/0603; R_0603_5MIL_DWS
R6, R7, R10, R11, R14, R15, R21, R25, R28, R30, R32, R36: 150R/1%/0603; R_0603_5MIL_DWS
VGA1: VGA15; VGA15-F(CD0515S21J0)

Connections:
+3.3V: J3.29; also elsewhere on the board
+5V_USB: J3.30; also elsewhere on the board
/ESP32/B0: J3.17; also elsewhere on the board
/ESP32/B1: J3.19; also elsewhere on the board
/ESP32/B2: J3.21; also elsewhere on the board
/ESP32/B3: J3.23; also elsewhere on the board
/ESP32/G0: J3.9; also elsewhere on the board
/ESP32/G1: J3.11; also elsewhere on the board
/ESP32/G2: J3.13; also elsewhere on the board
/ESP32/G3: J3.15; also elsewhere on the board
/ESP32/HSYNC: J3.27; also elsewhere on the board
/ESP32/R0: J3.1; also elsewhere on the board
/ESP32/R1: J3.3; also elsewhere on the board
/ESP32/R2: J3.5; also elsewhere on the board
/ESP32/R3: J3.7; also elsewhere on the board
/ESP32/VSYNC: J3.31; also elsewhere on the board
/Video/B: R32.2, R33.1, R36.2, VGA1.3 (Blue)
/Video/B0: J3.18, R27.2
/Video/B1: J3.20, R29.2
/Video/B2: J3.22, R31.2
/Video/B3: J3.24, R33.2
/Video/G: R15.2, R17.1, R25.2, VGA1.2 (Green)
/Video/G0: J3.10, R5.2
/Video/G1: J3.12, R9.2
/Video/G2: J3.14, R13.2
/Video/G3: J3.16, R17.2
/Video/R: R14.2, R16.1, R21.2, VGA1.1 (Red)
/Video/R0: J3.2, R4.2
/Video/R1: J3.4, R8.2
/Video/R2: J3.6, R12.2
/Video/R3: J3.8, R16.2
/Video/VGA_HSYNC: J3.28, VGA1.13 (HSync)
/Video/VGA_VSYNC: J3.32, VGA1.14 (VSync)
GND: J3.25, J3.26, R2.1, R3.1, R21.1, R25.1, R26.1, R36.1, VGA1.5 (GND), VGA1.6 (Red_RTN), VGA1.7 (Green_RTN), VGA1.8 (Blue_RTN), VGA1.10 (GND), VGA1.16 (Shield1), VGA1.17 (Shield2); also elsewhere on the board
unnamed: R2.2, R4.1, R6.1
unnamed: R3.2, R5.1, R7.1
unnamed: R6.2, R8.1, R10.1
unnamed: R10.2, R12.1, R14.1
unnamed: R7.2, R9.1, R11.1
unnamed: R11.2, R13.1, R15.1
unnamed: R26.2, R27.1, R28.1
unnamed: R28.2, R29.1, R30.1
unnamed: R30.2, R31.1, R32.1

Notes on the sheet:
DB3
DB4
LED_A
DB1
DB6
DB2
DB7
RST
DB5
DB0

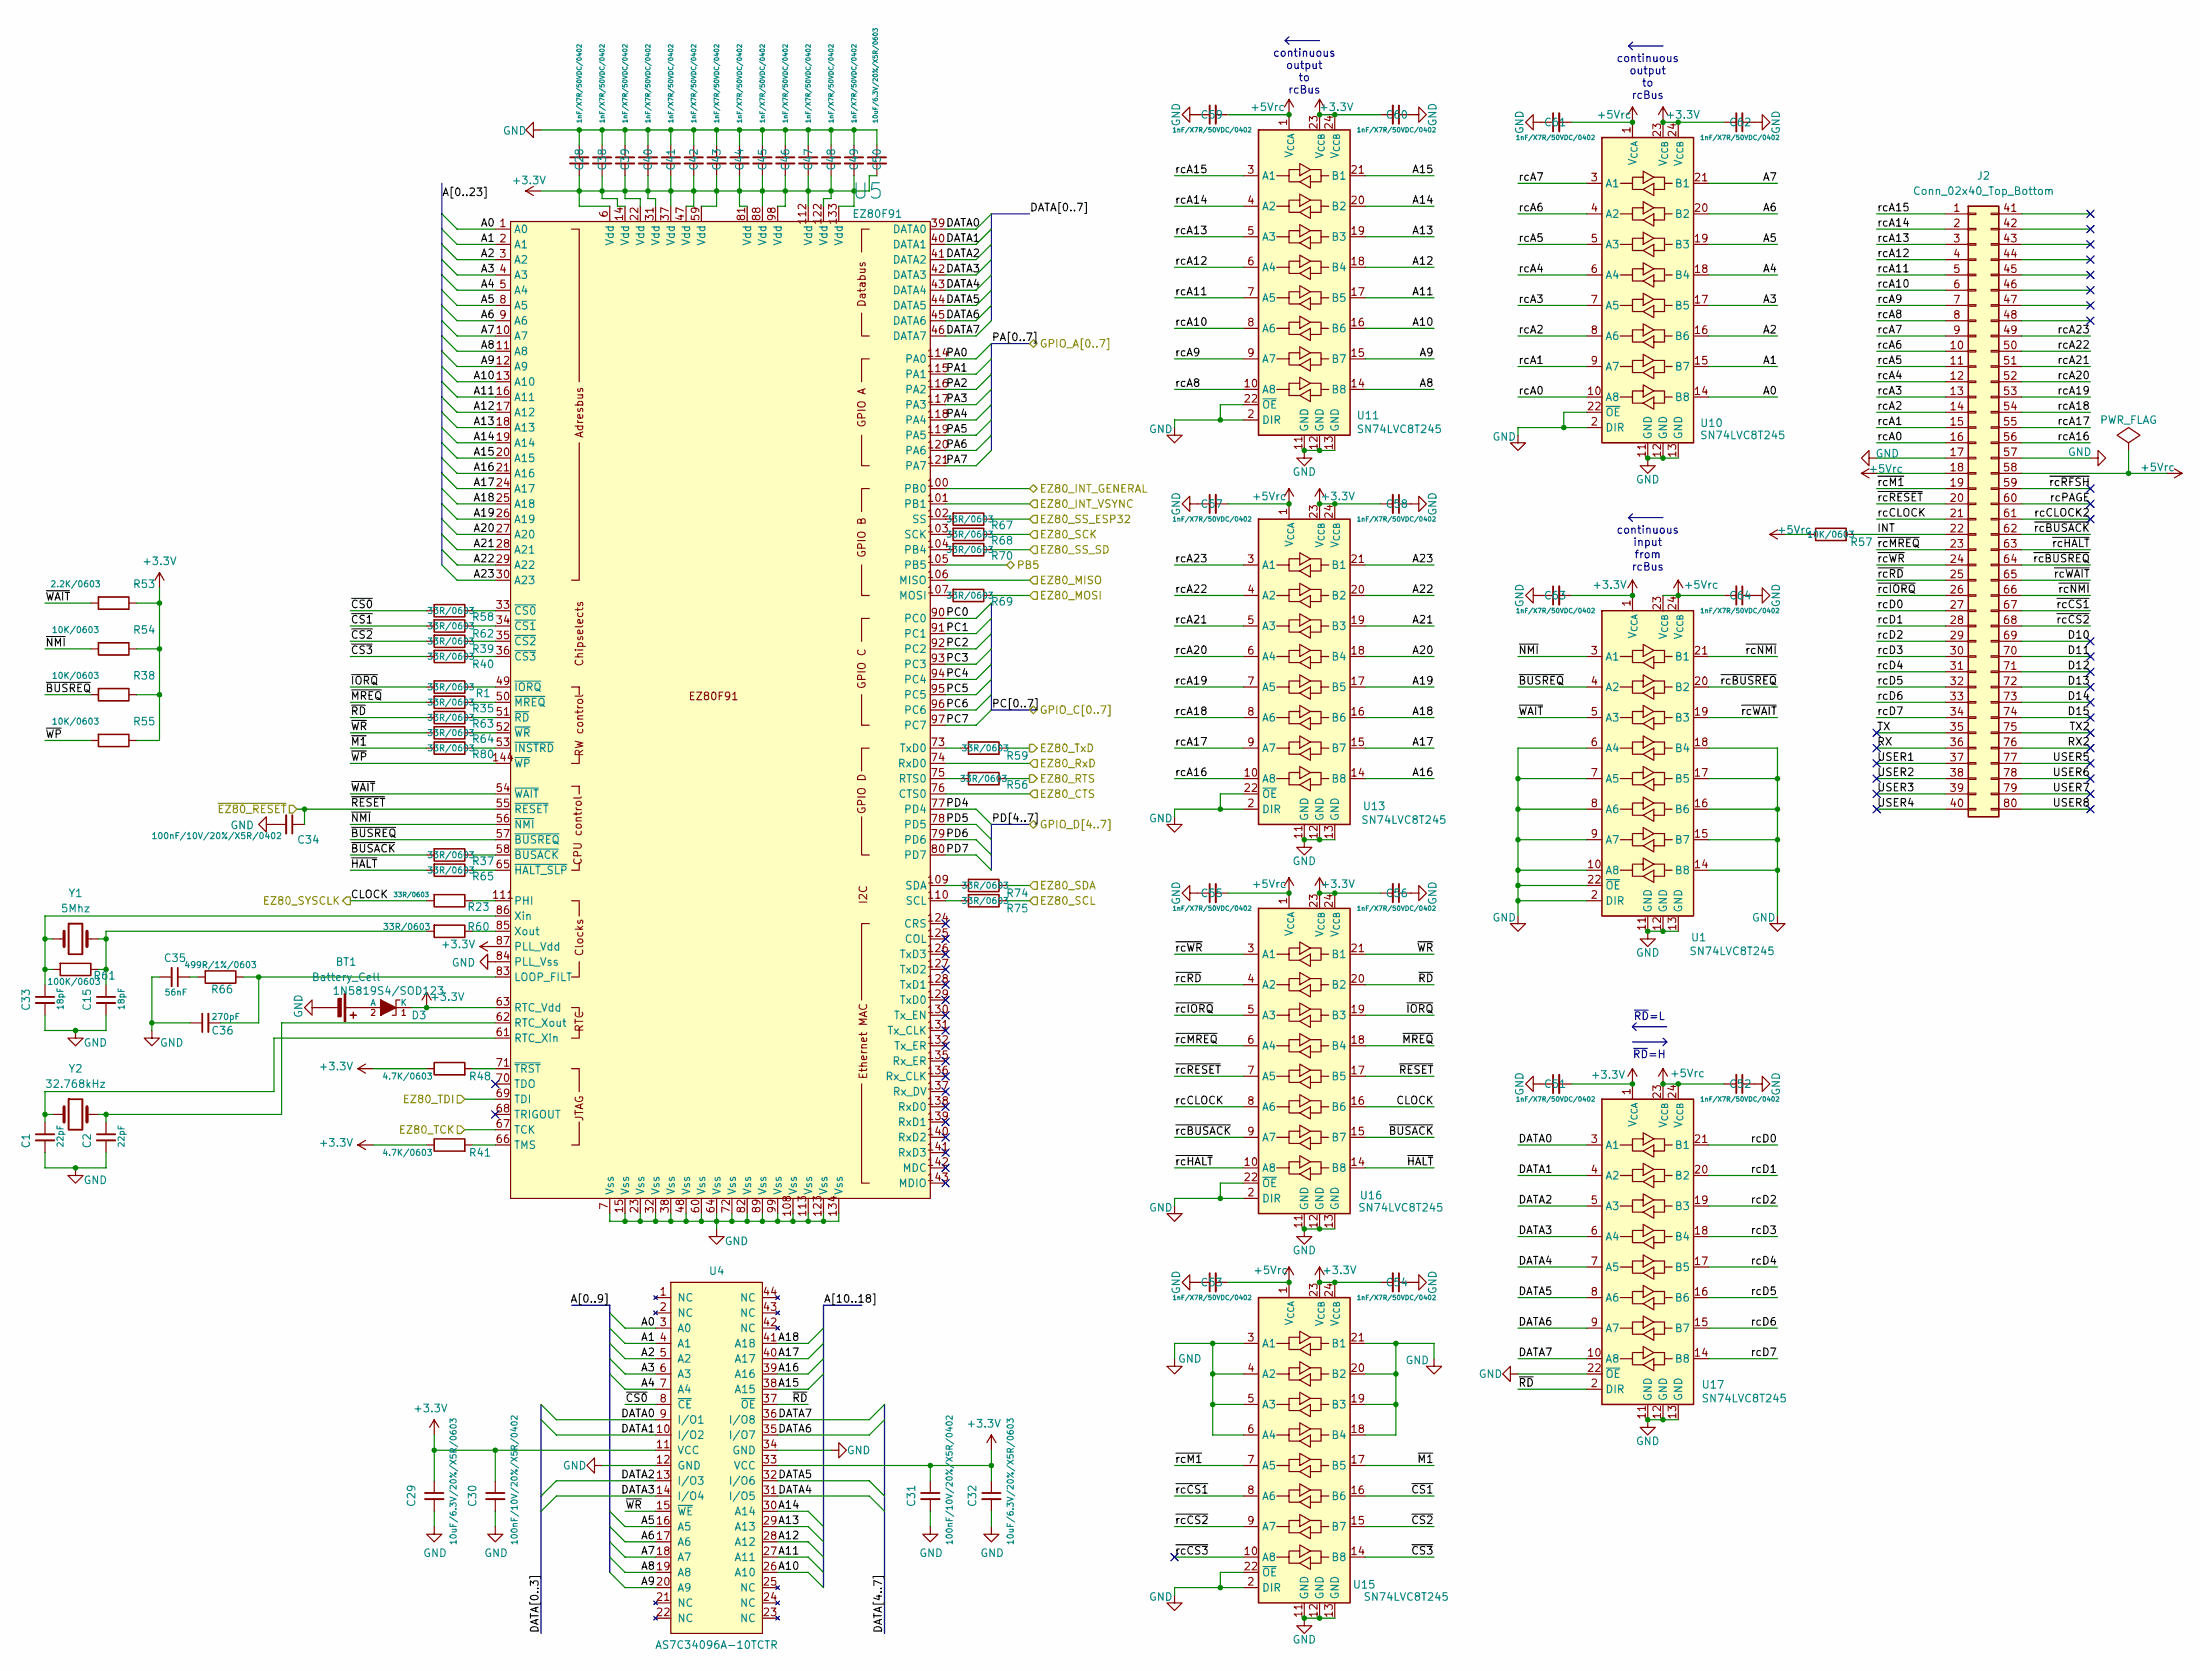
[picture p32: schematic ez80.kicad_sch]

Parts:
BT1: Battery_Cell; PinHeader_1x02_P2.54mm_Vertical
C1, C2: 22pF; C_0402_5MIL_DWS
C15, C33: 18pF; C_0402_5MIL_DWS
C28, C38, C39, C40, C41, C42, C43, C44, C45, C46, C47, C48, C49, C51, C52, C53, C54, C55, C56, C57, C58, C59, C60, C61, C62, C63, C64: 1nF/X7R/50VDC/0402; C_0402_5MIL_DWS
C29, C32, C50: 10uF/6.3V/20%/X5R/0603; C_0603_5MIL_DWS
C30, C31, C34: 100nF/10V/20%/X5R/0402; C_0402_5MIL_DWS
C35: 56nF; C_0402_5MIL_DWS
C36: 270pF; C_0402_5MIL_DWS
D3: 1N5819S4/SOD123; SOD-123_1C-2A_KA
J2: Conn_02x40_Top_Bottom; PinHeader_2x40_P2.54mm_Vertical
R1, R23, R35, R37, R39, R40, R56, R58, R59, R60, R62, R63, R64, R65, R67, R68, R69, R70, R74, R75, R80: 33R/0603; R_0603_5MIL_DWS
R38, R54, R55, R57: 10K/0603; R_0603_5MIL_DWS
R41, R48: 4.7K/0603; R_0603_5MIL_DWS
R53: 2.2K/0603; R_0603_5MIL_DWS
R61: 100K/0603; R_0603_5MIL_DWS
R66: 499R/1%/0603; R_0603_5MIL_DWS
U1, U10, U11, U13, U15, U16, U17: SN74LVC8T245; TSSOP-24_4.4x7.8mm_P0.65mm
U4: AS7C34096A-10TCTR; TSOP-44_Pitch-0.80mm_18.80x11.80x1.20mm
U5: EZ80F91; LQFP-144-1EP_20x20mm_P0.5mm_EP6.5x6.5mm
Y1: 5Mhz; Crystal_SMD_HC49-SD
Y2: 32.768kHz; Crystal_C26-LF_D2.1mm_L6.5mm_Horizontal

Connections:
+3.3V: C28.2, C29.1, C30.1, C31.1, C32.1, C38.2, C39.2, C40.2, C41.2, C42.2, C43.2, C44.2, C45.2, C46.2, C47.2, C48.2, C49.2, C50.2, C51.2, C54.2, C56.2, C58.2, C60.2, C62.2, C63.2, D3.1 (K), R38.1, R41.1, R48.1, R53.1, R54.1, R55.1, U1.1 (V_{CCA}), U4.11 (VCC), U4.33 (VCC), U5.6 (Vdd), U5.14 (Vdd), U5.22 (Vdd), U5.31 (Vdd), U5.37 (Vdd), U5.47 (Vdd), U5.59 (Vdd), U5.63 (RTC_Vdd), U5.81 (Vdd), U5.87 (PLL_Vdd), U5.88 (Vdd), U5.98 (Vdd), U5.112 (Vdd), U5.122 (Vdd), U5.133 (Vdd), U10.23 (V_{CCB}), U10.24 (V_{CCB}), U11.23 (V_{CCB}), U11.24 (V_{CCB}), U13.23 (V_{CCB}), U13.24 (V_{CCB}), U15.23 (V_{CCB}), U15.24 (V_{CCB}), U16.23 (V_{CCB}), U16.24 (V_{CCB}), U17.1 (V_{CCA}); also elsewhere on the board
+5Vrc: C52.2, C53.2, C55.2, C57.2, C59.2, C61.2, C64.2, J2.18, J2.58, R57.1, U1.23 (V_{CCB}), U1.24 (V_{CCB}), U10.1 (V_{CCA}), U11.1 (V_{CCA}), U13.1 (V_{CCA}), U15.1 (V_{CCA}), U16.1 (V_{CCA}), U17.23 (V_{CCB}), U17.24 (V_{CCB})
/ESP32/ESP_CTS: R56.1; also elsewhere on the board
/ESP32/ESP_INT_GENERAL: U5.100 (PB0); also elsewhere on the board
/ESP32/ESP_RTS: U5.76 (CTS0); also elsewhere on the board
/ESP32/ESP_RxD: R59.1; also elsewhere on the board
/ESP32/ESP_SPI_MISO: U5.106 (MISO); also elsewhere on the board
/ESP32/ESP_SPI_MOSI: R69.1; also elsewhere on the board
/ESP32/ESP_SPI_SCLK: R68.1; also elsewhere on the board
/ESP32/ESP_SPI_SS: R67.1; also elsewhere on the board
/ESP32/ESP_TxD: U5.74 (RxD0); also elsewhere on the board
/ESP32/VSYNC: U5.101 (PB1); also elsewhere on the board
/EZ80 ports/EZ80_SCL: R75.1; also elsewhere on the board
/EZ80 ports/EZ80_SDA: R74.1; also elsewhere on the board
/EZ80 ports/EZ80_SS_SD: R70.1; also elsewhere on the board
/EZ80 ports/EZ80_TCK: U5.67 (TCK); also elsewhere on the board
/EZ80 ports/EZ80_TDI: U5.69 (TDI); also elsewhere on the board
/EZ80 ports/GPIO_B5: U5.105 (PB5); also elsewhere on the board
/EZ80/A0: U4.3 (A0), U5.1 (A0), U10.14 (B8)
/EZ80/A1: U4.4 (A1), U5.2 (A1), U10.15 (B7)
/EZ80/A2: U4.5 (A2), U5.3 (A2), U10.16 (B6)
/EZ80/A3: U4.6 (A3), U5.4 (A3), U10.17 (B5)
/EZ80/A4: U4.7 (A4), U5.5 (A4), U10.18 (B4)
/EZ80/A5: U4.16 (A5), U5.8 (A5), U10.19 (B3)
/EZ80/A6: U4.17 (A6), U5.9 (A6), U10.20 (B2)
/EZ80/A7: U4.18 (A7), U5.10 (A7), U10.21 (B1)
/EZ80/A8: U4.19 (A8), U5.11 (A8), U11.14 (B8)
/EZ80/A9: U4.20 (A9), U5.12 (A9), U11.15 (B7)
/EZ80/A10: U4.26 (A10), U5.13 (A10), U11.16 (B6)
/EZ80/A11: U4.27 (A11), U5.16 (A11), U11.17 (B5)
/EZ80/A12: U4.28 (A12), U5.17 (A12), U11.18 (B4)
/EZ80/A13: U4.29 (A13), U5.18 (A13), U11.19 (B3)
/EZ80/A14: U4.30 (A14), U5.19 (A14), U11.20 (B2)
/EZ80/A15: U4.38 (A15), U5.20 (A15), U11.21 (B1)
/EZ80/A16: U4.39 (A16), U5.21 (A16), U13.14 (B8)
/EZ80/A17: U4.40 (A17), U5.24 (A17), U13.15 (B7)
/EZ80/A18: U4.41 (A18), U5.25 (A18), U13.16 (B6)
/EZ80/A19: U5.26 (A19), U13.17 (B5)
/EZ80/A20: U5.27 (A20), U13.18 (B4)
/EZ80/A21: U5.28 (A21), U13.19 (B3)
/EZ80/A22: U5.29 (A22), U13.20 (B2)
/EZ80/A23: U5.30 (A23), U13.21 (B1)
/EZ80/CLOCK: R23.2, U16.16 (B6); also elsewhere on the board
/EZ80/D10: J2.69
/EZ80/D11: J2.70
/EZ80/D12: J2.71
/EZ80/D13: J2.72
/EZ80/D14: J2.73
/EZ80/D15: J2.74
/EZ80/DATA0: U4.9 (I/O1), U5.39 (DATA0), U17.3 (A1)
/EZ80/DATA1: U4.10 (I/O2), U5.40 (DATA1), U17.4 (A2)
/EZ80/DATA2: U4.13 (I/O3), U5.41 (DATA2), U17.5 (A3)
/EZ80/DATA3: U4.14 (I/O4), U5.42 (DATA3), U17.6 (A4)
/EZ80/DATA4: U4.31 (I/O5), U5.43 (DATA4), U17.7 (A5)
/EZ80/DATA5: U4.32 (I/O6), U5.44 (DATA5), U17.8 (A6)
/EZ80/DATA6: U4.35 (I/O7), U5.45 (DATA6), U17.9 (A7)
/EZ80/DATA7: U4.36 (I/O8), U5.46 (DATA7), U17.10 (A8)
/EZ80/INT: J2.22, R57.2
/EZ80/PA0: U5.114 (PA0); also elsewhere on the board
/EZ80/PA1: U5.115 (PA1); also elsewhere on the board
/EZ80/PA2: U5.116 (PA2); also elsewhere on the board
/EZ80/PA3: U5.117 (PA3); also elsewhere on the board
/EZ80/PA4: U5.118 (PA4); also elsewhere on the board
/EZ80/PA5: U5.119 (PA5); also elsewhere on the board
/EZ80/PA6: U5.120 (PA6); also elsewhere on the board
/EZ80/PA7: U5.121 (PA7); also elsewhere on the board
/EZ80/PC0: U5.90 (PC0); also elsewhere on the board
/EZ80/PC1: U5.91 (PC1); also elsewhere on the board
/EZ80/PC2: U5.92 (PC2); also elsewhere on the board
/EZ80/PC3: U5.93 (PC3); also elsewhere on the board
/EZ80/PC4: U5.94 (PC4); also elsewhere on the board
/EZ80/PC5: U5.95 (PC5); also elsewhere on the board
/EZ80/PC6: U5.96 (PC6); also elsewhere on the board
/EZ80/PC7: U5.97 (PC7); also elsewhere on the board
/EZ80/PD4: U5.77 (PD4); also elsewhere on the board
/EZ80/PD5: U5.78 (PD5); also elsewhere on the board
/EZ80/PD6: U5.79 (PD6); also elsewhere on the board
/EZ80/PD7: U5.80 (PD7); also elsewhere on the board
/EZ80/RX: J2.36
/EZ80/RX2: J2.76
/EZ80/TX: J2.35
/EZ80/TX2: J2.75
/EZ80/USER1: J2.37
/EZ80/USER2: J2.38
/EZ80/USER3: J2.39
/EZ80/USER4: J2.40
/EZ80/USER5: J2.77
/EZ80/USER6: J2.78
/EZ80/USER7: J2.79
/EZ80/USER8: J2.80
/EZ80/rcA0: J2.16, U10.10 (A8)
/EZ80/rcA1: J2.15, U10.9 (A7)
/EZ80/rcA2: J2.14, U10.8 (A6)
/EZ80/rcA3: J2.13, U10.7 (A5)
/EZ80/rcA4: J2.12, U10.6 (A4)
/EZ80/rcA5: J2.11, U10.5 (A3)
/EZ80/rcA6: J2.10, U10.4 (A2)
/EZ80/rcA7: J2.9, U10.3 (A1)
/EZ80/rcA8: J2.8, U11.10 (A8)
/EZ80/rcA9: J2.7, U11.9 (A7)
/EZ80/rcA10: J2.6, U11.8 (A6)
/EZ80/rcA11: J2.5, U11.7 (A5)
/EZ80/rcA12: J2.4, U11.6 (A4)
/EZ80/rcA13: J2.3, U11.5 (A3)
/EZ80/rcA14: J2.2, U11.4 (A2)
/EZ80/rcA15: J2.1, U11.3 (A1)
/EZ80/rcA16: J2.56, U13.10 (A8)
/EZ80/rcA17: J2.55, U13.9 (A7)
/EZ80/rcA18: J2.54, U13.8 (A6)
/EZ80/rcA19: J2.53, U13.7 (A5)
/EZ80/rcA20: J2.52, U13.6 (A4)
/EZ80/rcA21: J2.51, U13.5 (A3)
/EZ80/rcA22: J2.50, U13.4 (A2)
/EZ80/rcA23: J2.49, U13.3 (A1)
/EZ80/rcCLOCK: J2.21, U16.8 (A6)
/EZ80/rcCLOCK2: J2.61
/EZ80/rcD0: J2.27, U17.21 (B1)
/EZ80/rcD1: J2.28, U17.20 (B2)
/EZ80/rcD2: J2.29, U17.19 (B3)
/EZ80/rcD3: J2.30, U17.18 (B4)
/EZ80/rcD4: J2.31, U17.17 (B5)
/EZ80/rcD5: J2.32, U17.16 (B6)
/EZ80/rcD6: J2.33, U17.15 (B7)
/EZ80/rcD7: J2.34, U17.14 (B8)
/EZ80/rcPAGE: J2.60
/EZ80/~BUSACK: R37.2, U16.15 (B7)
/EZ80/~BUSREQ: R38.2, U1.4 (A2), U5.57 (~BUSREQ)
/EZ80/~CS0: R58.2, U4.8 (~CE)
/EZ80/~CS1: R62.2, U15.16 (B6)
/EZ80/~CS2: R39.2, U15.15 (B7)
/EZ80/~CS3: R40.2, U15.14 (B8)
/EZ80/~HALT: R65.2, U16.14 (B8)
/EZ80/~IORQ: R1.2, U16.19 (B3)
/EZ80/~M1: R80.2, U15.17 (B5)
/EZ80/~MREQ: R35.2, U16.18 (B4)
/EZ80/~NMI: R54.2, U1.3 (A1), U5.56 (~NMI)
/EZ80/~RD: R63.2, U4.37 (~OE), U16.20 (B2), U17.2 (DIR)
/EZ80/~RESET: C34.1, U5.55 (~RESET), U16.17 (B5); also elsewhere on the board
/EZ80/~WAIT: R53.2, U1.5 (A3), U5.54 (~WAIT)
/EZ80/~WP: R55.2, U5.144 (~WP)
/EZ80/~WR: R64.2, U4.15 (~WE), U16.21 (B1)
/EZ80/~rcBUSACK: J2.62, U16.9 (A7)
/EZ80/~rcBUSREQ: J2.64, U1.20 (B2)
/EZ80/~rcCS1: J2.67, U15.8 (A6)
/EZ80/~rcCS2: J2.68, U15.9 (A7)
/EZ80/~rcCS3: U15.10 (A8)
/EZ80/~rcHALT: J2.63, U16.10 (A8)
/EZ80/~rcIORQ: J2.26, U16.5 (A3)
/EZ80/~rcM1: J2.19, U15.7 (A5)
/EZ80/~rcMREQ: J2.23, U16.6 (A4)
/EZ80/~rcNMI: J2.66, U1.21 (B1)
/EZ80/~rcRD: J2.25, U16.4 (A2)
/EZ80/~rcRESET: J2.20, U16.7 (A5)
/EZ80/~rcRFSH: J2.59
/EZ80/~rcWAIT: J2.65, U1.19 (B3)
/EZ80/~rcWR: J2.24, U16.3 (A1)
GND: BT1.2 (-), C1.2, C2.2, C15.2, C28.1, C29.2, C30.2, C31.2, C32.2, C33.2, C34.2, C35.2, C36.1, C38.1, C39.1, C40.1, C41.1, C42.1, C43.1, C44.1, C45.1, C46.1, C47.1, C48.1, C49.1, C50.1, C51.1, C52.1, C53.1, C54.1, C55.1, C56.1, C57.1, C58.1, C59.1, C60.1, C61.1, C62.1, C63.1, C64.1, J2.17, J2.57, U1.2 (DIR), U1.6 (A4), U1.7 (A5), U1.8 (A6), U1.9 (A7), U1.10 (A8), U1.11 (GND), U1.12 (GND), U1.13 (GND), U1.14 (B8), U1.15 (B7), U1.16 (B6), U1.17 (B5), U1.18 (B4), U1.22 (~OE), U4.12 (GND), U4.34 (GND), U5.7 (Vss), U5.15 (Vss), U5.23 (Vss), U5.32 (Vss), U5.38 (Vss), U5.48 (Vss), U5.60 (Vss), U5.64 (Vss), U5.72 (Vss), U5.82 (Vss), U5.84 (PLL_Vss), U5.89 (Vss), U5.99 (Vss), U5.108 (Vss), U5.113 (Vss), U5.123 (Vss), U5.134 (Vss), U10.2 (DIR), U10.11 (GND), U10.12 (GND), U10.13 (GND), U10.22 (~OE), U11.2 (DIR), U11.11 (GND), U11.12 (GND), U11.13 (GND), U11.22 (~OE), U13.2 (DIR), U13.11 (GND), U13.12 (GND), U13.13 (GND), U13.22 (~OE), U15.2 (DIR), U15.3 (A1), U15.4 (A2), U15.5 (A3), U15.6 (A4), U15.11 (GND), U15.12 (GND), U15.13 (GND), U15.18 (B4), U15.19 (B3), U15.20 (B2), U15.21 (B1), U15.22 (~OE), U16.2 (DIR), U16.11 (GND), U16.12 (GND), U16.13 (GND), U16.22 (~OE), U17.11 (GND), U17.12 (GND), U17.13 (GND), U17.22 (~OE); also elsewhere on the board
unnamed: BT1.1 (+), D3.2 (A)
unnamed: C15.1, R60.2, R61.1, Y1.2
unnamed: C35.1, R66.2
unnamed: R59.2, U5.73 (TxD0)
unnamed: C36.2, R66.1, U5.83 (LOOP_FILT)
unnamed: R67.2, U5.102 (SS)
unnamed: R68.2, U5.103 (SCK)
unnamed: R70.2, U5.104 (PB4)
unnamed: R69.2, U5.107 (MOSI)
unnamed: R56.2, U5.75 (RTS0)
unnamed: R23.1, U5.111 (PHI)
unnamed: C1.1, U5.61 (RTC_Xin), Y2.1
unnamed: C2.1, U5.62 (RTC_Xout), Y2.2
unnamed: R75.2, U5.110 (SCL)
unnamed: R74.2, U5.109 (SDA)
unnamed: R41.2, U5.66 (TMS)
unnamed: C33.1, R61.2, U5.86 (Xin), Y1.1
unnamed: R60.1, U5.85 (Xout)
unnamed: R37.1, U5.58 (~BUSACK)
unnamed: R58.1, U5.33 (~CS0)
unnamed: R62.1, U5.34 (~CS1)
unnamed: R39.1, U5.35 (~CS2)
unnamed: R40.1, U5.36 (~CS3)
unnamed: R65.1, U5.65 (~HALT_SLP)
unnamed: R80.1, U5.53 (~INSTRD)
unnamed: R1.1, U5.49 (~IORQ)
unnamed: R35.1, U5.50 (~MREQ)
unnamed: R63.1, U5.51 (~RD)
unnamed: R48.2, U5.71 (~TRST)
unnamed: R64.1, U5.52 (~WR)

Notes on the sheet:
continuous output to rcBus
~{RD}=L
continuous input from rcBus
~{RD}=H

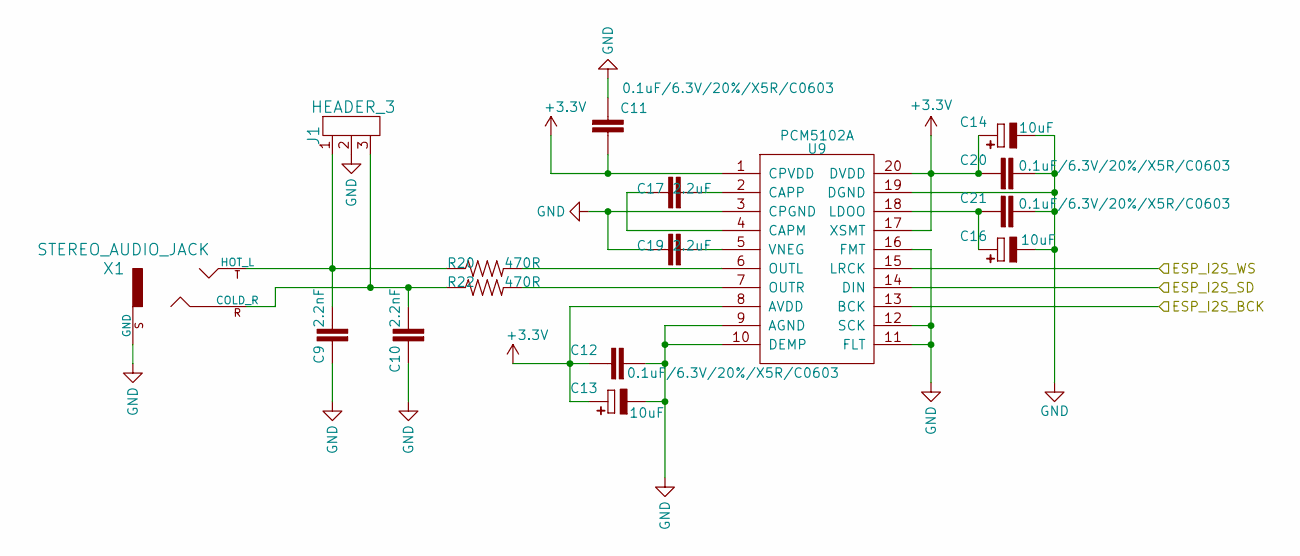
[picture p33: schematic audio.kicad_sch]

Parts:
C9, C10: 2.2nF; C_0603_5MIL_DWS
C11, C12, C20, C21: 0.1uF/6.3V/20%/X5R/C0603; C_0603_5MIL_DWS
C13, C14, C16: 10uF; C_0603_5MIL_DWS
C17, C19: 2.2uF; C_0603_5MIL_DWS
J1: HEADER_3; PinHeader_1x03_P2.54mm_Vertical
R20, R22: 470R; R_0603_5MIL_DWS
U9: PCM5102A; TSSOP-20_4.4x6.5mm_P0.65mm
X1: STEREO_AUDIO_JACK; Jack_3.5mm_CUI_SJ-3523-SMT_Horizontal

Connections:
+3.3V: C11.2, C12.1, C13.1 (+), C14.1 (+), C20.1, U9.1 (CPVDD), U9.8 (AVDD), U9.17 (XSMT), U9.20 (DVDD); also elsewhere on the board
/Audio/ESP_I2S_BCK: U9.13 (BCK); also elsewhere on the board
/Audio/ESP_I2S_SD: U9.14 (DIN); also elsewhere on the board
/Audio/ESP_I2S_WS: U9.15 (LRCK); also elsewhere on the board
GND: C9.1, C10.1, C11.1, C12.2, C13.2 (-), C14.2 (-), C16.2 (-), C19.1, C20.2, C21.2, J1.2, U9.3 (CPGND), U9.9 (AGND), U9.10 (DEMP), U9.11 (FLT), U9.12 (SCK), U9.16 (FMT), U9.19 (DGND), X1.S (GND); also elsewhere on the board
unnamed: C16.1 (+), C21.1, U9.18 (LDOO)
unnamed: C17.1, U9.4 (CAPM)
unnamed: C17.2, U9.2 (CAPP)
unnamed: R20.2, U9.6 (OUTL)
unnamed: R22.2, U9.7 (OUTR)
unnamed: C19.2, U9.5 (VNEG)
unnamed: C10.2, J1.3, R22.1, X1.R (COLD_R)
unnamed: C9.2, J1.1, R20.1, X1.T (HOT_L)
