S0urceror/HexAgon/HexAgon.kicad_pcb

## KiCad design HexAgon.kicad_pcb (continued)

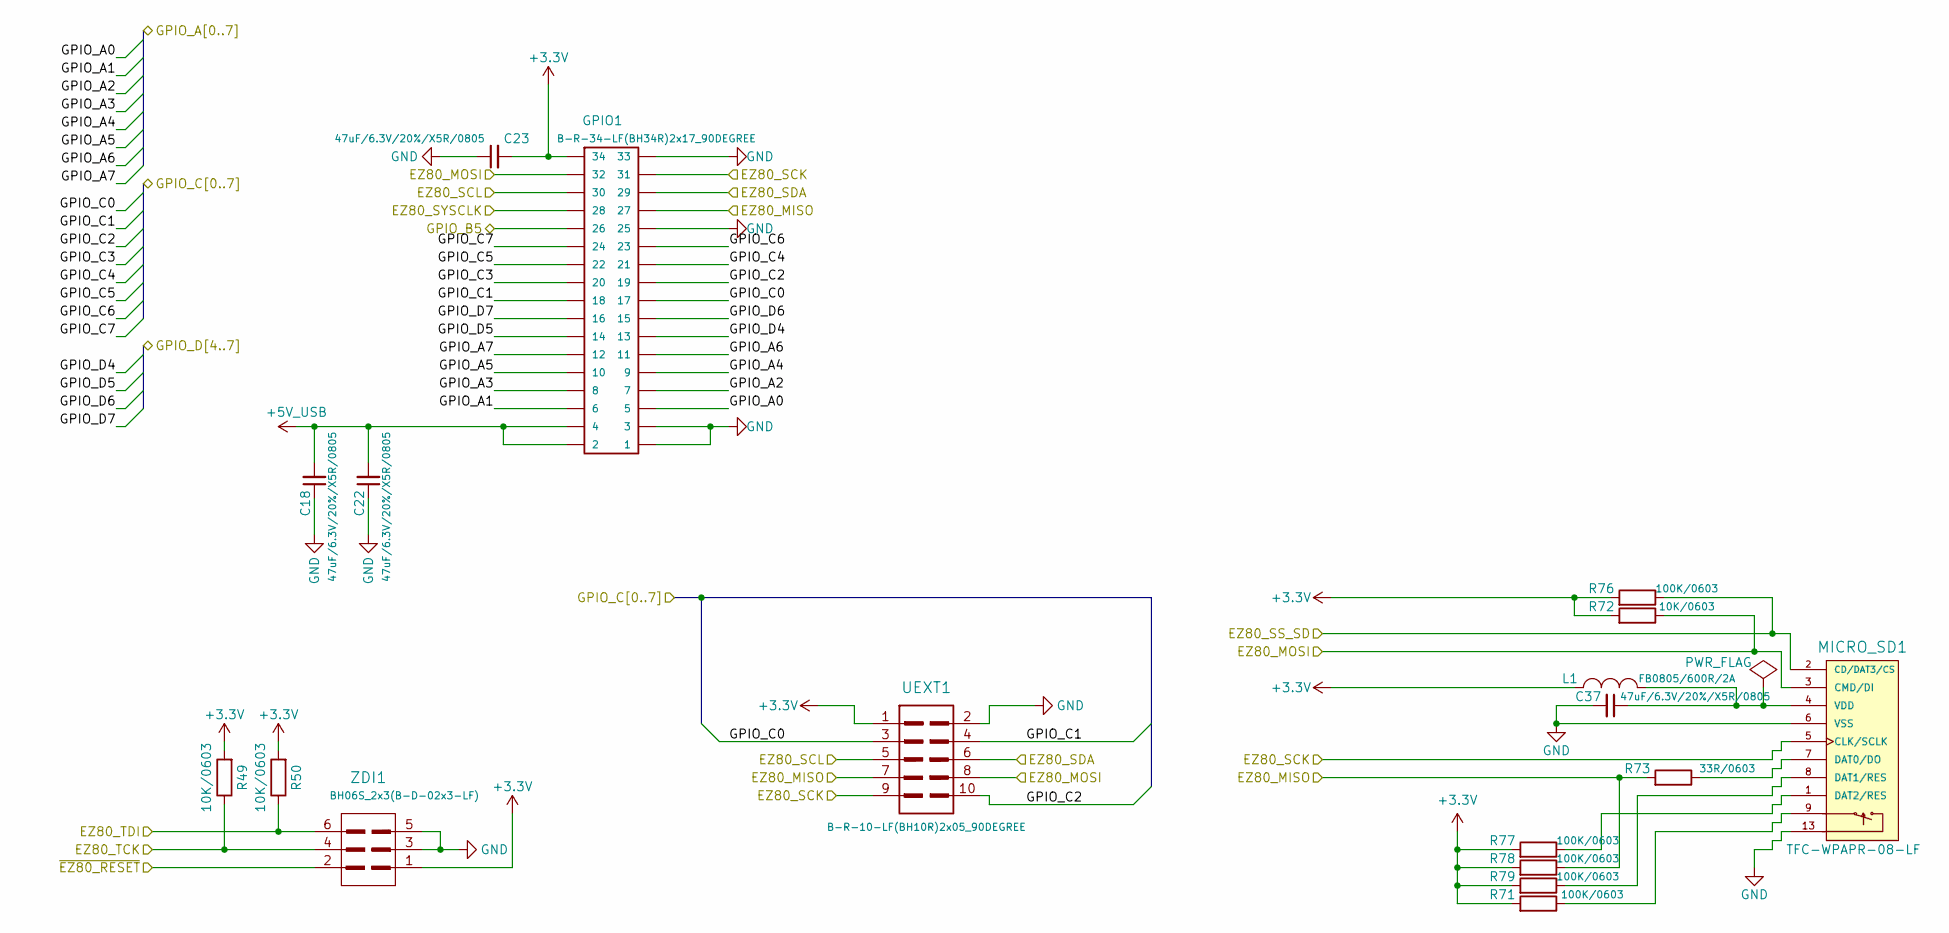
[picture p34: schematic ez80_ports.kicad_sch]

Parts:
C18, C22, C23, C37: 47uF/6.3V/20%/X5R/0805; C_0805_5MIL_DWS
GPIO1: B-R-34-LF(BH34R)2x17_90DEGREE; BH34R
L1: FB0805/600R/2A; L_0805_5MIL_DWS
MICRO_SD1: TFC-WPAPR-08-LF; TFC-WPAPR-08
R49, R50, R72: 10K/0603; R_0603_5MIL_DWS
R71, R76, R77, R78, R79: 100K/0603; R_0603_5MIL_DWS
R73: 33R/0603; R_0603_5MIL_DWS
UEXT1: B-R-10-LF(BH10R)2x05_90DEGREE; UEXT_BH10R
ZDI1: BH06S_2x3(B-D-02x3-LF); BH06S

Connections:
+3.3V: C23.2, GPIO1.34, L1.1, R49.2, R50.2, R71.2, R72.2, R76.2, R77.2, R78.2, R79.2, UEXT1.1, ZDI1.1; also elsewhere on the board
+5V_USB: C18.2, C22.2, GPIO1.2, GPIO1.4; also elsewhere on the board
/ESP32/ESP_SPI_MISO: GPIO1.27, R73.2, R78.1, UEXT1.7; also elsewhere on the board
/ESP32/ESP_SPI_MOSI: GPIO1.32, MICRO_SD1.3 (CMD/DI), R72.1, UEXT1.8; also elsewhere on the board
/ESP32/ESP_SPI_SCLK: GPIO1.31, MICRO_SD1.5 (CLK/SCLK), UEXT1.9; also elsewhere on the board
/EZ80 ports/EZ80_SCL: GPIO1.30, UEXT1.5; also elsewhere on the board
/EZ80 ports/EZ80_SDA: GPIO1.29, UEXT1.6; also elsewhere on the board
/EZ80 ports/EZ80_SS_SD: MICRO_SD1.2 (CD/DAT3/CS), R76.1; also elsewhere on the board
/EZ80 ports/EZ80_TCK: R49.1, ZDI1.4; also elsewhere on the board
/EZ80 ports/EZ80_TDI: R50.1, ZDI1.6; also elsewhere on the board
/EZ80 ports/GPIO_B5: GPIO1.26; also elsewhere on the board
/EZ80/CLOCK: GPIO1.28; also elsewhere on the board
/EZ80/PA0: GPIO1.5; also elsewhere on the board
/EZ80/PA1: GPIO1.6; also elsewhere on the board
/EZ80/PA2: GPIO1.7; also elsewhere on the board
/EZ80/PA3: GPIO1.8; also elsewhere on the board
/EZ80/PA4: GPIO1.9; also elsewhere on the board
/EZ80/PA5: GPIO1.10; also elsewhere on the board
/EZ80/PA6: GPIO1.11; also elsewhere on the board
/EZ80/PA7: GPIO1.12; also elsewhere on the board
/EZ80/PC0: GPIO1.17, UEXT1.3; also elsewhere on the board
/EZ80/PC1: GPIO1.18, UEXT1.4; also elsewhere on the board
/EZ80/PC2: GPIO1.19, UEXT1.10; also elsewhere on the board
/EZ80/PC3: GPIO1.20; also elsewhere on the board
/EZ80/PC4: GPIO1.21; also elsewhere on the board
/EZ80/PC5: GPIO1.22; also elsewhere on the board
/EZ80/PC6: GPIO1.23; also elsewhere on the board
/EZ80/PC7: GPIO1.24; also elsewhere on the board
/EZ80/PD4: GPIO1.13; also elsewhere on the board
/EZ80/PD5: GPIO1.14; also elsewhere on the board
/EZ80/PD6: GPIO1.15; also elsewhere on the board
/EZ80/PD7: GPIO1.16; also elsewhere on the board
/EZ80/~RESET: ZDI1.2; also elsewhere on the board
GND: C18.1, C22.1, C23.1, C37.2, GPIO1.1, GPIO1.3, GPIO1.25, GPIO1.33, MICRO_SD1.6 (VSS), MICRO_SD1.10, MICRO_SD1.11, MICRO_SD1.12, MICRO_SD1.13, UEXT1.2, ZDI1.3, ZDI1.5; also elsewhere on the board
unnamed: MICRO_SD1.7 (DAT0/DO), R73.1
unnamed: MICRO_SD1.8 (DAT1/RES), R79.1
unnamed: MICRO_SD1.1 (DAT2/RES), R77.1
unnamed: MICRO_SD1.9, R71.1
unnamed: C37.1, L1.2, MICRO_SD1.4 (VDD)

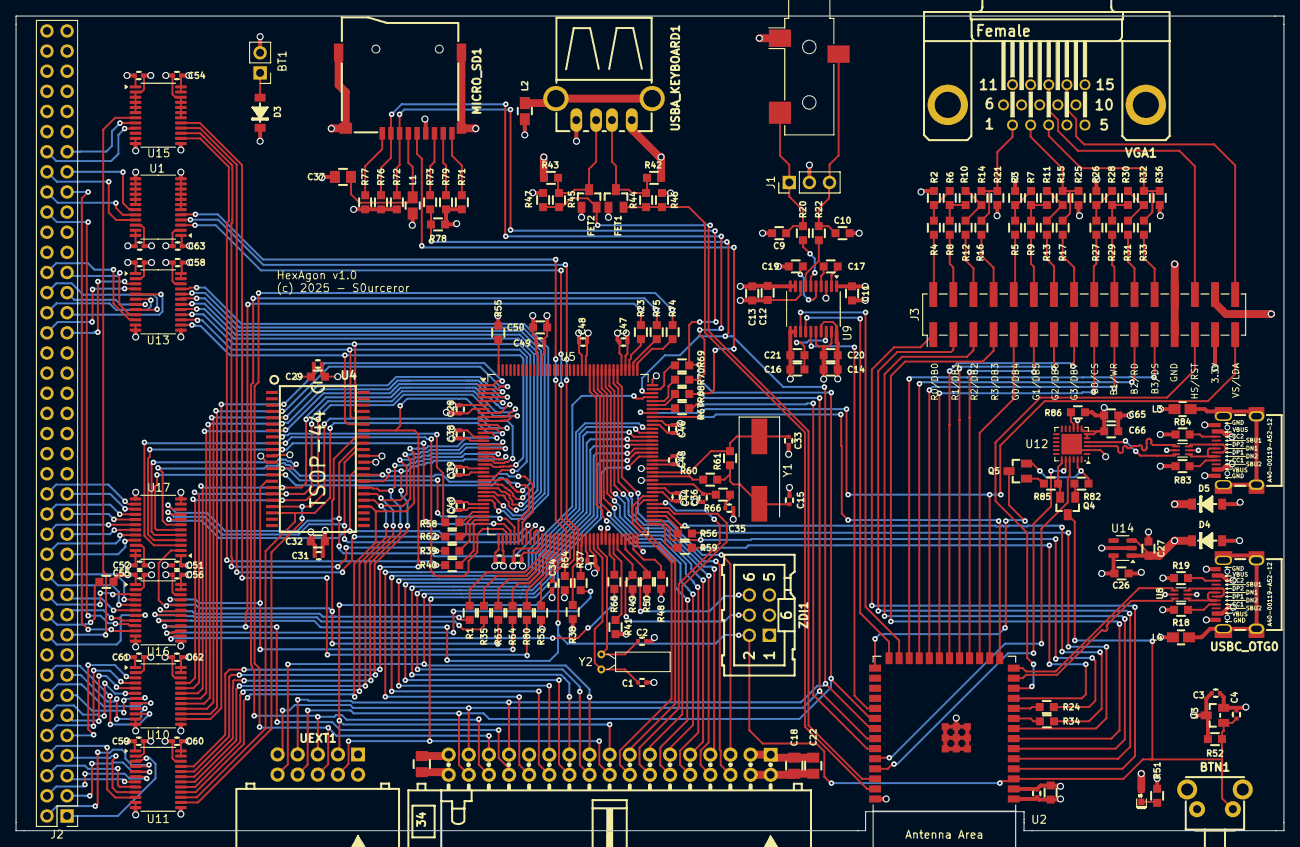
[picture p35: board HexAgon.kicad_pcb from above]

Board: 4 copper layers, 160.0 x 102.8 mm, 191 parts (0 on the bottom side), 253 nets.
