S0urceror/HexAgon/(commit log)

2024-11-05 initial setup
    [HexAgon.kicad_pcb, HexAgon.kicad_sch, audio.kicad_sch, esp32.kicad_sch, ez80.kicad_sch, keyboard_usb.kicad_sch, video.kicad_sch]
2025-05-10 schematics finished, pcb routing 80%
    [HexAgon.kicad_pcb, HexAgon.kicad_sch, audio.kicad_sch, esp32.kicad_sch, ez80.kicad_sch, ez80_ports.kicad_sch, keyboard_usb.kicad_sch, video.kicad_sch]
2025-05-18 v1.0 version PCB
    [72w2538_292303-4.stp, ALSRobot-BUZZER.step, Audio_Jack-3.5mm---CUI_SJ1-3515-SMT-TR.step, B3F_3150.step, BH-10__64.step, BH34R_CH87342H100.STEP, DO-214AC_SMA.step, ESP32-PICO-D4.STEP]
2025-05-26 1st production and BOM
    [HexAgon-B_Cu.gbr, HexAgon-B_Mask.gbr, HexAgon-B_Paste.gbr, HexAgon-B_Silkscreen.gbr, HexAgon-Edge_Cuts.gbr, HexAgon-F_Cu.gbr, HexAgon-F_Mask.gbr, HexAgon-F_Paste.gbr]
2025-05-26 hide mfgcodes from schematic
    [audio.kicad_sch, esp32.kicad_sch, ez80.kicad_sch, ez80_ports.kicad_sch]
2025-06-08 PCB being built, recording errata
    [keyboard_usb.kicad_sch]
2025-08-17 fixed SD card issues
    [HexAgon.kicad_pcb, HexAgon.kicad_sch]
2025-08-24 all components tested, errata final
    [HexAgon.kicad_pcb]
