S0urceror/HexAgon/(notices)

Notices in the files:
3d/HN1x2-PinHeader_1x02_P2.54mm_Vertical.step:
Copyright (C) 2017, kicad StepUp
This work is licensed under the [Creative Commons CC-BY-SA 4.0 License](https://creativecommons.org/licenses/by-sa/4.0/legalcode),
with the following exception:
To the extent that the creation of electronic designs that use 'Licensed Material' can be considered to be 'Adapted Material',
You are free to use the library data in your own projects without the obligation to share your project files under this or any other license agreement.
HexAgon.kicad_pcb:
(c) 2025 - S0urceror
